drewsum/Analog_Clock/misc/custom_meter_name_plate_inverted.pdf

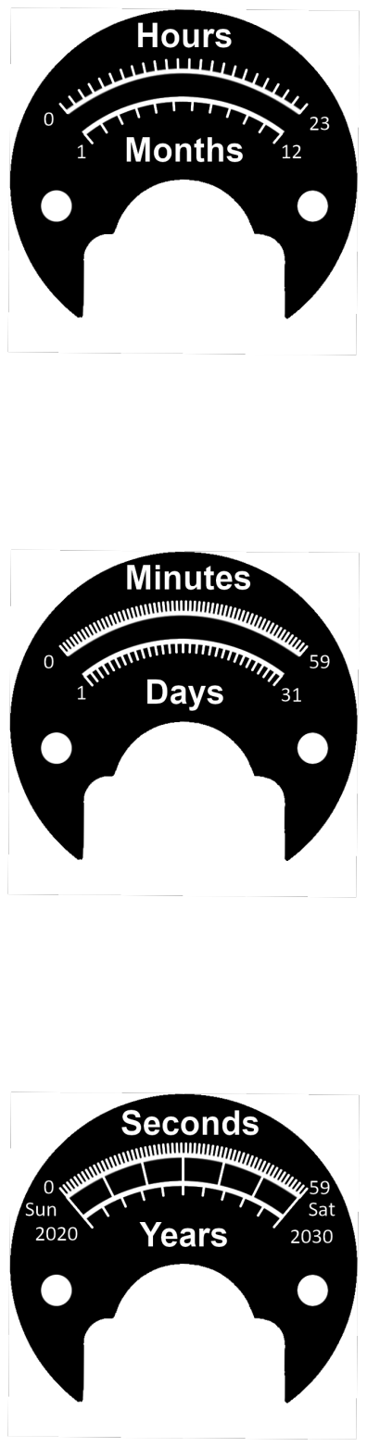
[picture p1: page 1]
