drewsum/Analog_Clock/misc/custom_meter_name_plate.pdf

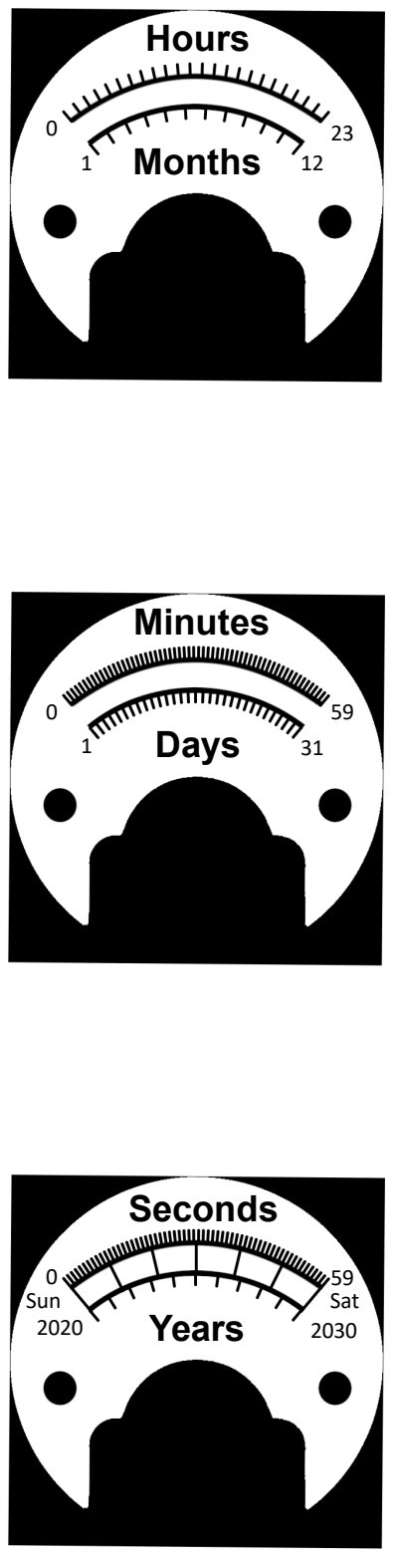
[picture p2: page 1]

Hours

Minutes

Seconds

1

1

2020

Sun | Sat

0

0

0

12

31

2030

23

59

59

Months

Days

Years
