drewsum/Analog_Clock/misc/image2020-11-04-160824-1.jpg

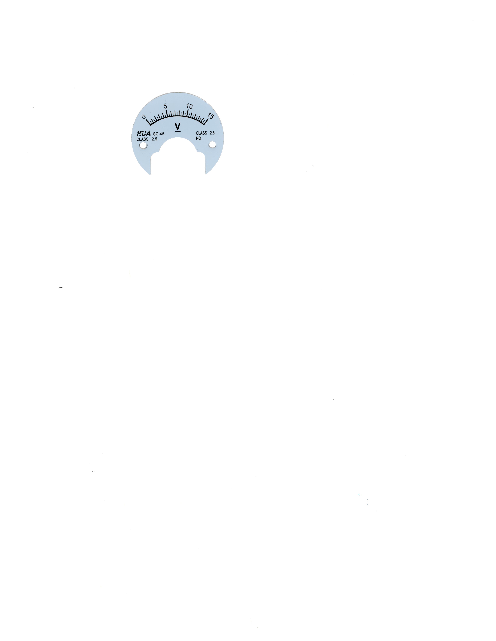
misc/image2020-11-04-160824-1.jpg
