drewsum/Analog_Clock/(threads)

Thread 1 (2020-02-05):

Ideas for this

drewsum, 2020-02-05:
* Use a voltage panel meter, preferably 0-5V but could also use 0-15V or something like that to add a higher voltage output and associated circuitry
* Would prefer to use a really retro set of round glass analog meters, as opposed to rectangular plastic ones
* Add warm LED backlight to the meters, make a set of custom cutouts to show hours, minutes, seconds
* Use a SPI DAC to control each meter. Use something like the DAC8551 for each meter
* Have a cool acrylic or metal laser cut front panel to hold everything together
* Can't decide if I want to solder the meters directly to the control board or have some wires as an interface
* Back could either be open or enclosed within wood or something
* 12V in, USB port (vertical mount instead of right angle), maybe bluetooth if you can figure it out
* ADC measurements for each analog output
* Consider using the 64 pin version of the PIC32MZ, probably don't need high memory option
* Maybe make panel meter backlight a configurable color?? Like RGB LEDs? That could be cool

drewsum, 2020-02-05:
* Consider having two boards, one that has all logic and power and the other that breaks out the connections to the meters. This would simplify layout of the control board but would make this more expensive/drive size thicker

drewsum, 2020-02-05:
* Consider mechanical pushbuttons as a way to set the time

drewsum, 2020-02-13:
Use the OPA990 as the analog output gain stage/buffer

drewsum, 2020-02-14:
> ~Use the OPA990 as the analog output gain stage/buffer~ This is a new part and doesn't appear to be available

Dropping this in favor of the OPA2197 in VSSOP-8, going to use amp A as gain stage and amp B as  a low pass filter for driving the meters. This is a nice option since KiCad already has this

drewsum, 2020-02-14:
You can get away with using a taller axial battery in this application. Don't do two boards, this only needs one

Closed 2020-10-15.

Thread 4 (2020-04-20):

Change VCCIO on FT234 to 3.3V

drewsum, 2020-04-20:
Abs Max: VCCIO IO Voltage -0.3 to +4.0

You've violated this on every board you've ever made with this, hahaha

Closed 2020-10-15.

Thread 5 (2020-08-13):

Consider tying a PWM output pin to heartbeat LED

drewsum, 2020-08-13:
You could change heartbeat timer from 1s period to 1ms, and update a PWM output to fade the heartbeat LED on and off. This would also provide a millisecond timer. Could be useful for heartbeat timer to be 1ms period rather than 1s period

Closed 2020-10-15.

Thread 10 (2020-11-01):

I2C devices don't initialize properly on a power on reset without USB plugged in

drewsum, 2020-11-01:

drewsum, 2020-11-01:
You can see evidence of this since calling `Platform Status?` shows that the LP5009 is not enabled after POR, even after init code executes

Closed 2020-11-13.

Thread 13 (2020-12-01):

Firmware Bug Fixes

drewsum, 2020-12-01:
* Middle meter voltage range is messed up after adding new meter inserts
* INA219 Print Status function prints the opposite BUS voltage range setting (16V instead of 32V, 32V instead of 16V)

Closed 2020-12-06.
