drewsum/Analog_Clock/hdw/Analog_Clock/Analog_Clock.pdf

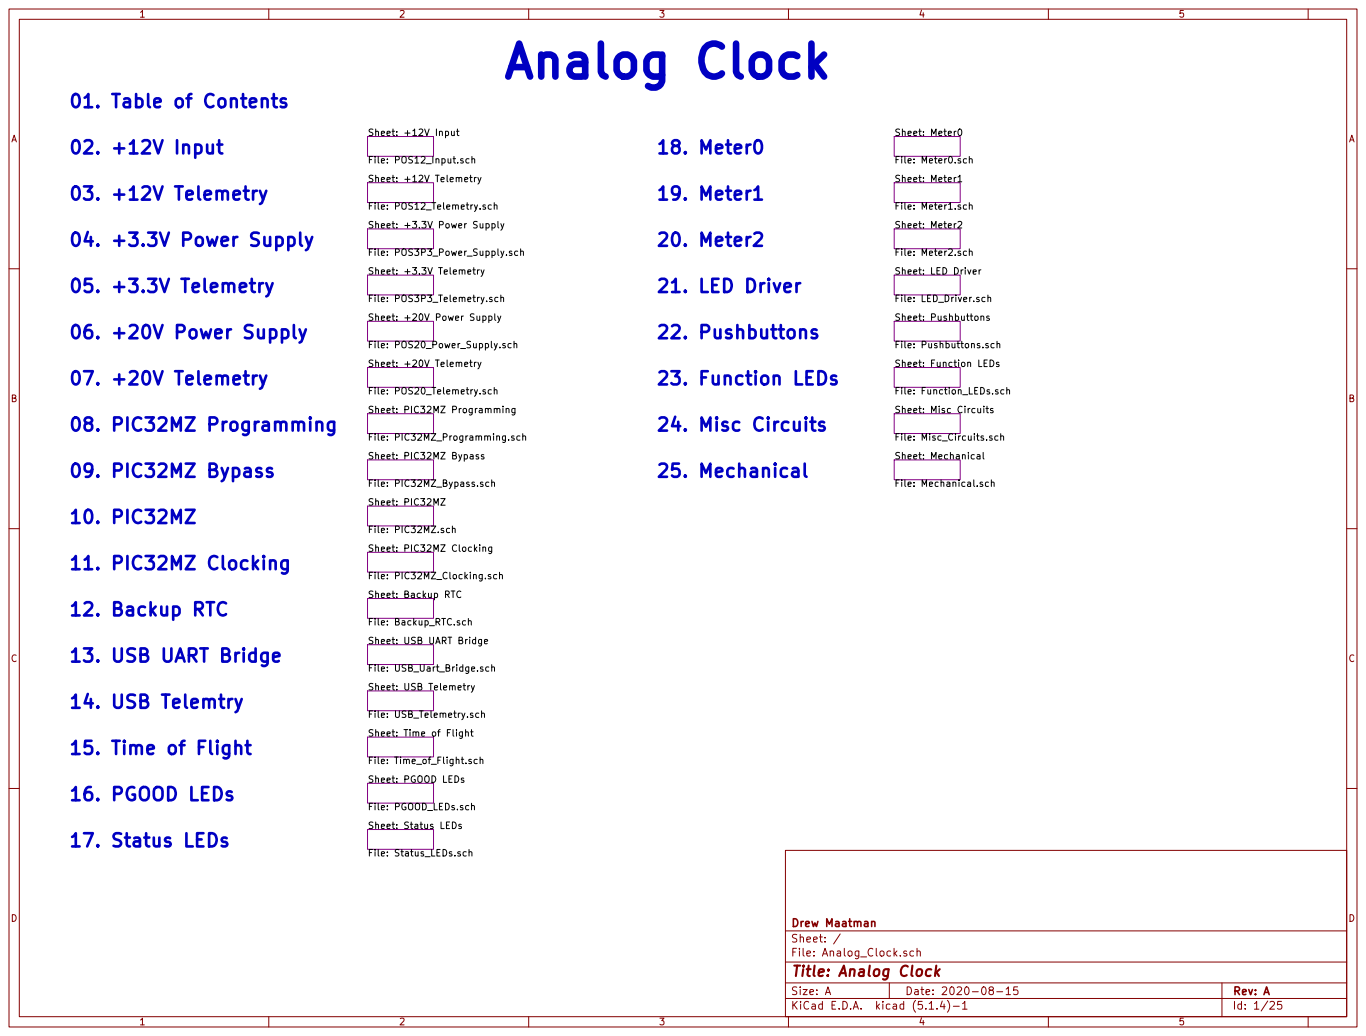
[picture p4: page 1]

File: POS12_Telemetry.sch Sheet: Status LEDs File: Status_LEDs.sch Sheet: PGOOD LEDs File: PGOOD_LEDs.sch Sheet: Time of Flight
Sheet: +3.3V Power Supply

File: PIC32MZ_Programming.sch
File: PIC32MZ.sch Sheet: PIC32MZ Bypass

File: Analog_Clock.sch Sheet: / Drew Maatman

Id: 1/25 Title: Analog Clock

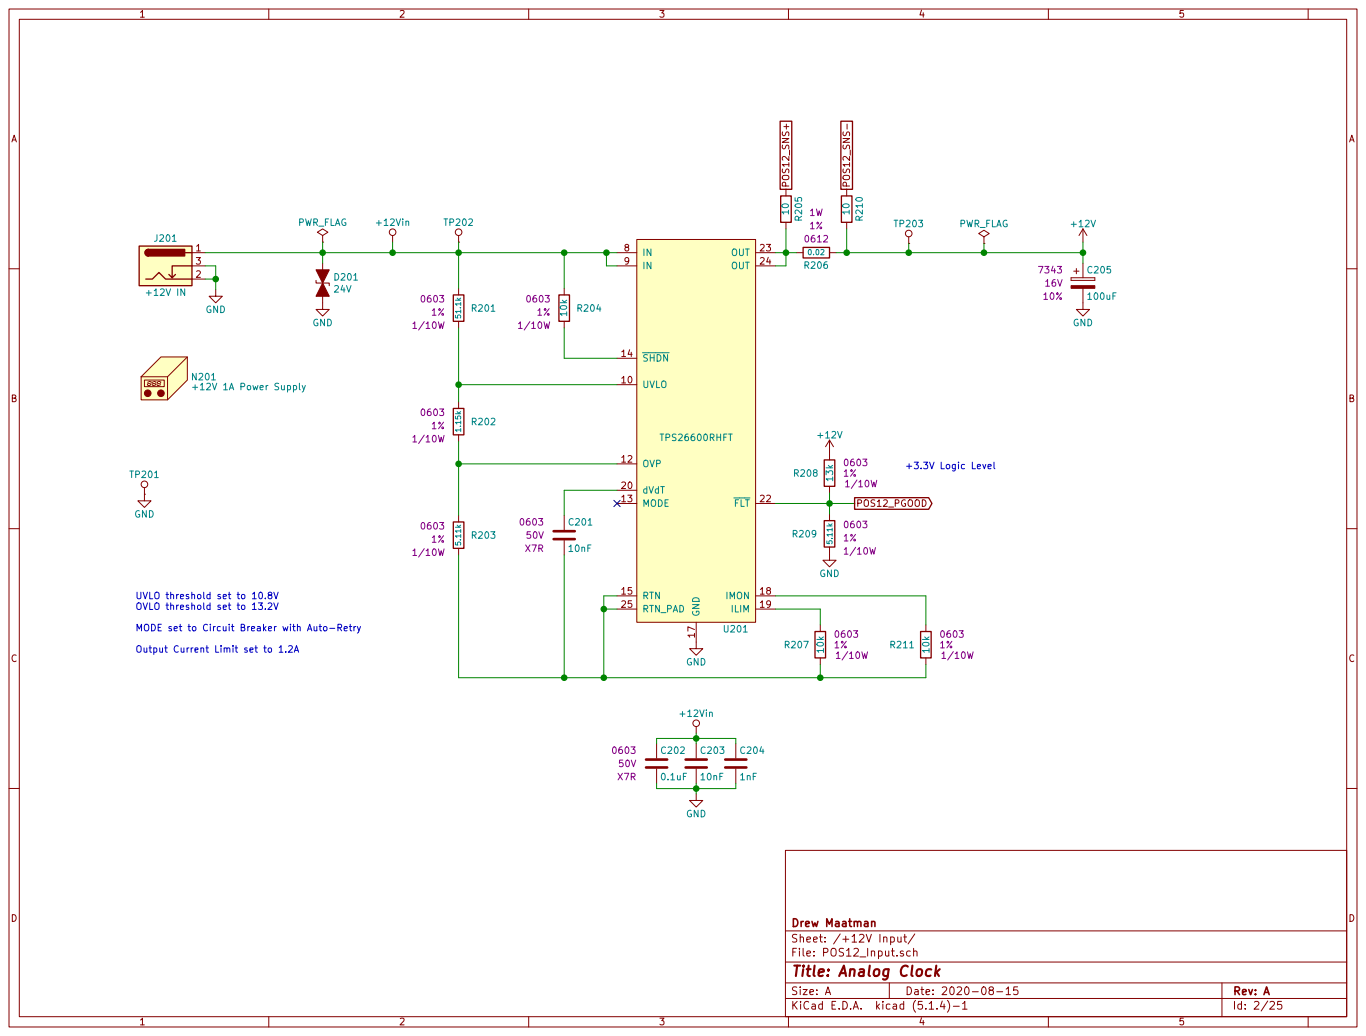
[picture p5: page 2]

+3.3V Logic Level UVLO threshold set to 10.8V OVLO threshold set to 13.2V MODE set to Circuit Breaker with Auto-Retry

Output Current Limit set to 1.2A

File: POS12_Input.sch
Id: 2/25 Title: Analog Clock

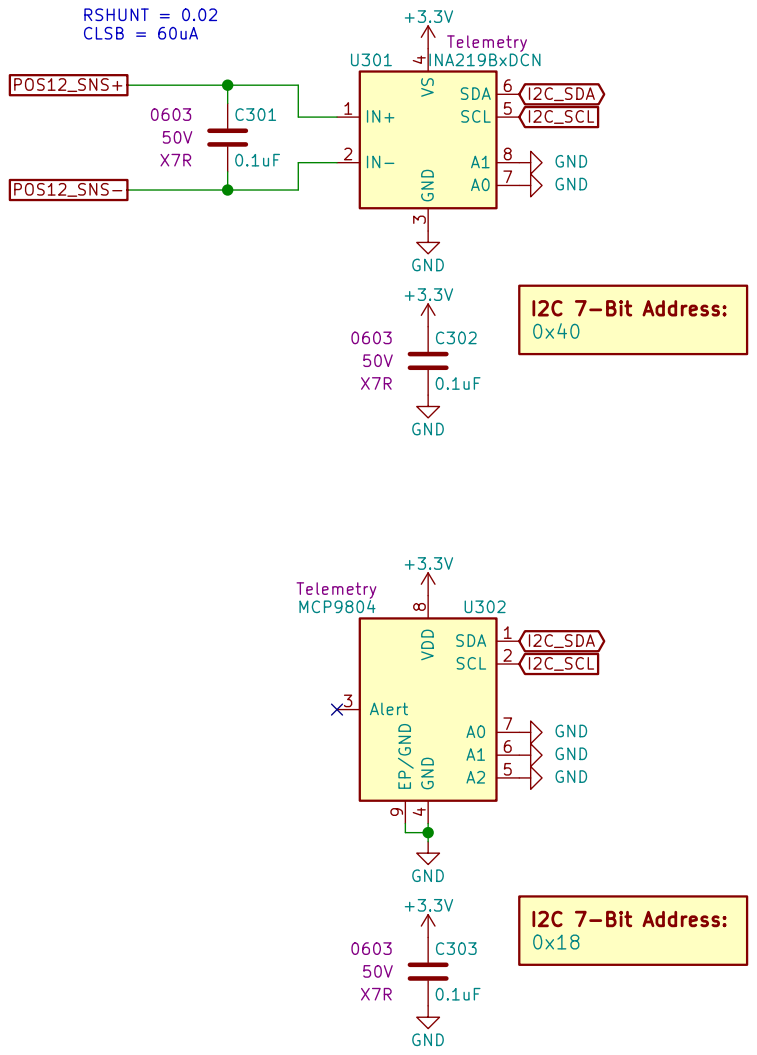
[picture p6: page 3]

Sheet: /+12V Telemetry/ Drew Maatman

File: POS12_Telemetry.sch
Id: 3/25 Title: Analog Clock

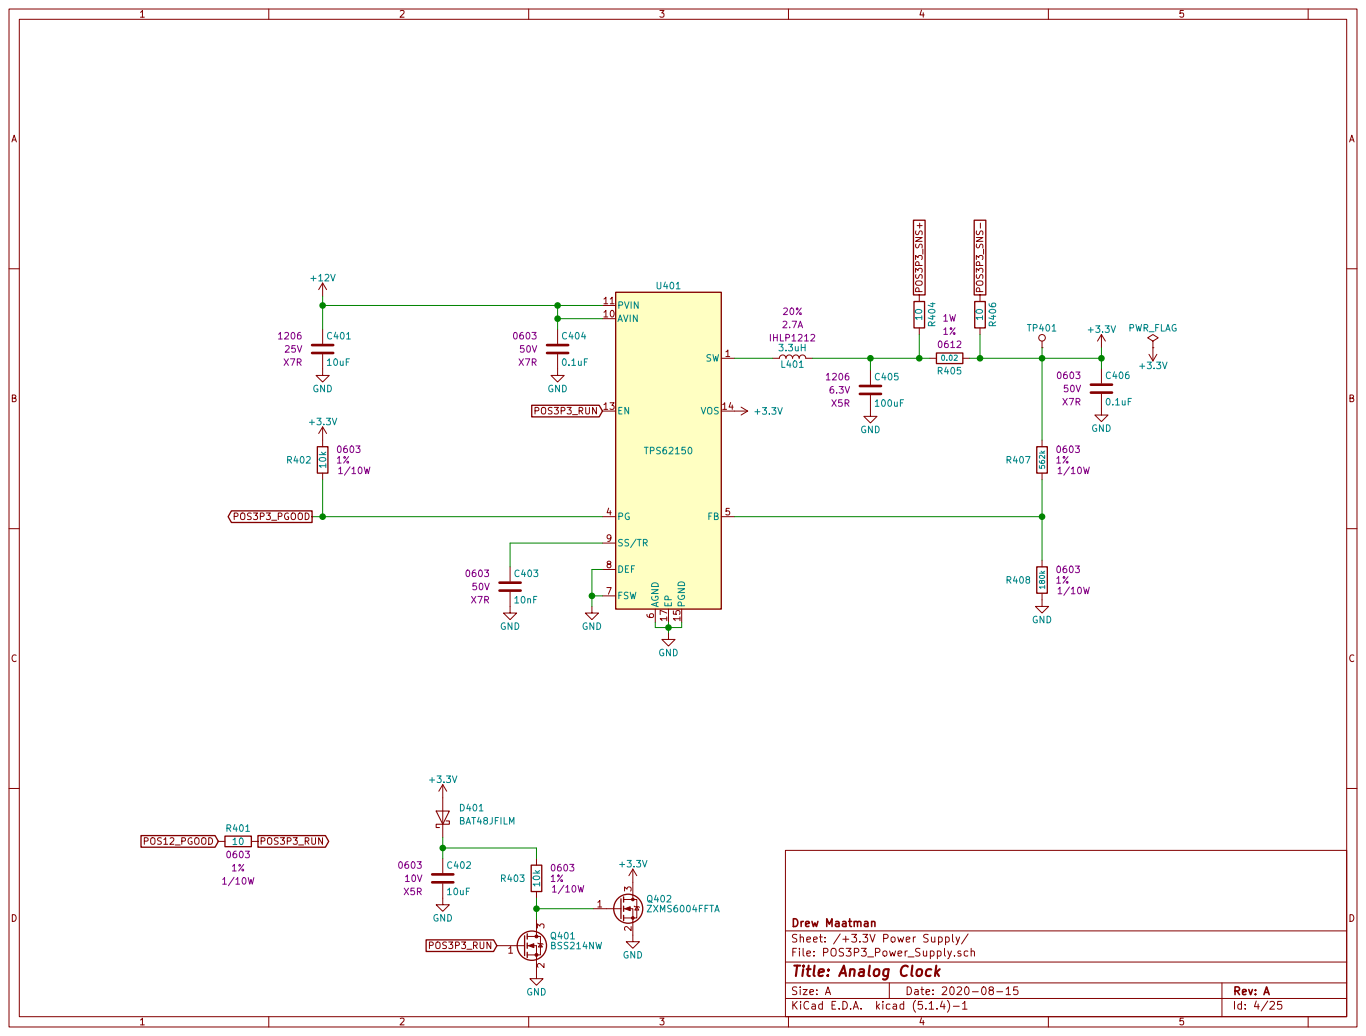
[picture p7: page 4]

6 FSW 7 DEF 8 SS/TR 9 U401 TPS62150 POS3P3_RUN

File: POS3P3_Power_Supply.sch
Id: 4/25 Title: Analog Clock

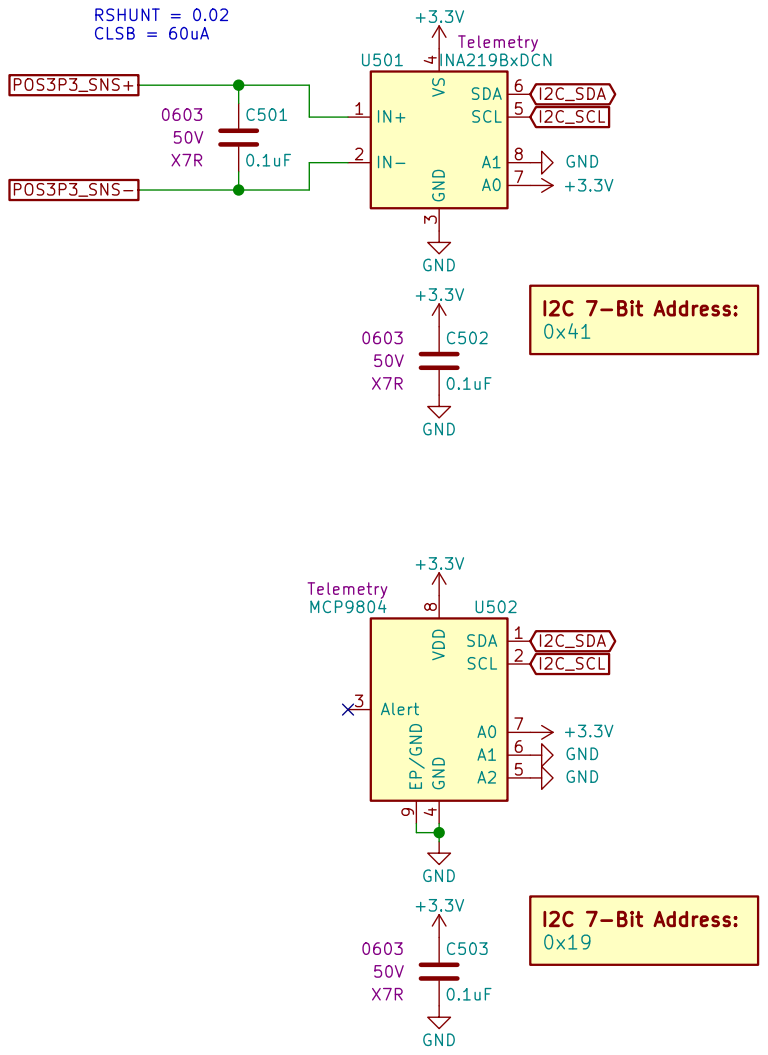
[picture p8: page 5]

Sheet: /+3.3V Telemetry/ Drew Maatman

File: POS3P3_Telemetry.sch
Id: 5/25 Title: Analog Clock

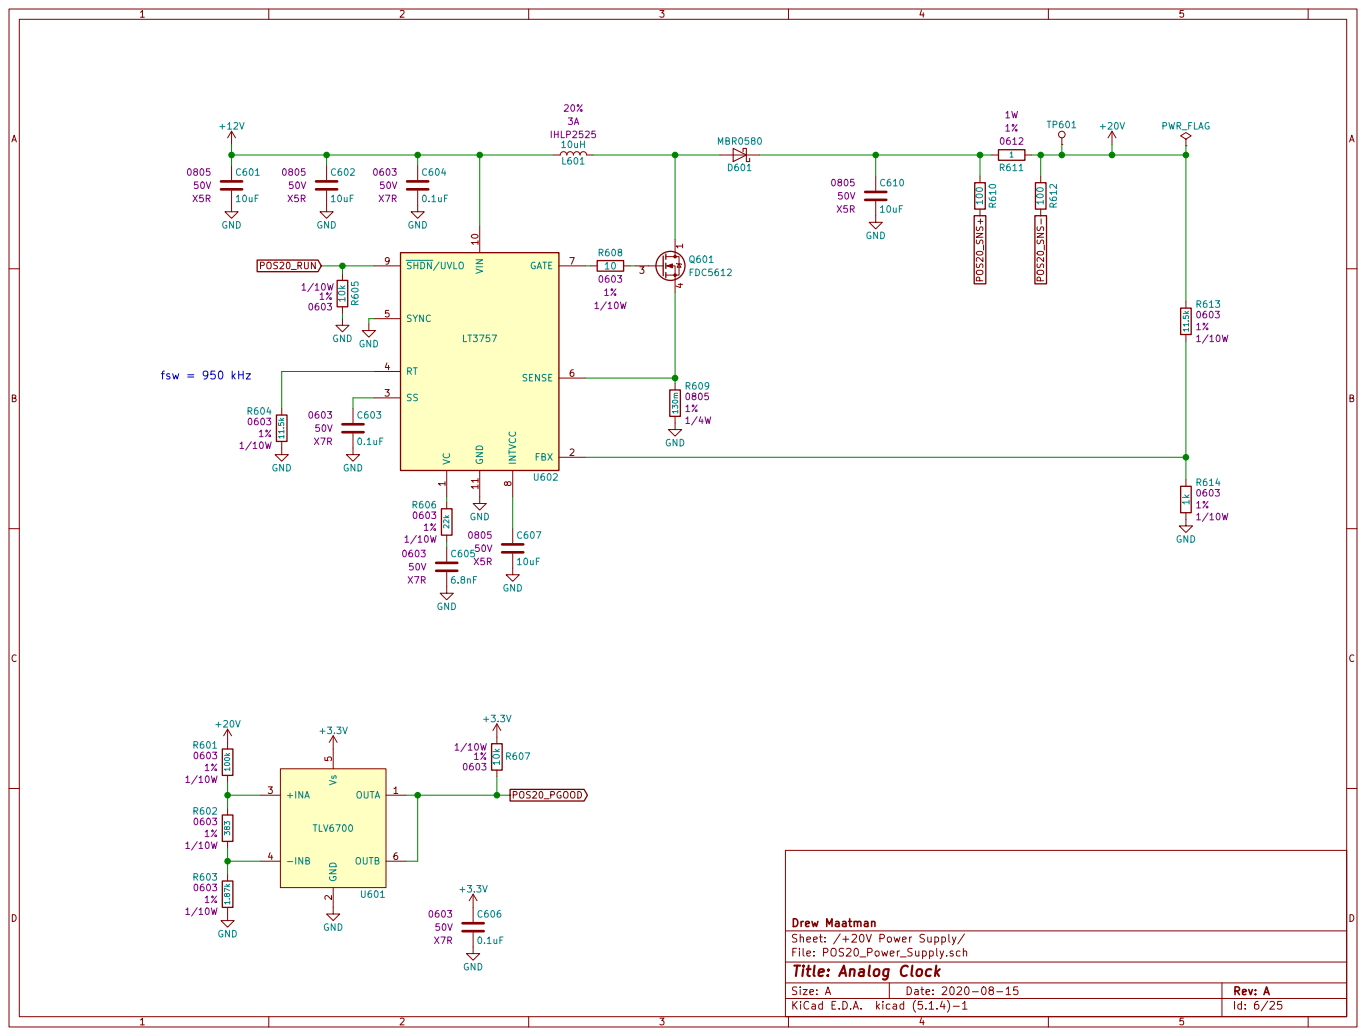
[picture p9: page 6]

1 VIN 10 GND 11 FBX 2 SS 3 RT 4 SYNC 5 SENSE 6 GATE 7 INTVCC

Sheet: /+20V Power Supply/ Drew Maatman GND R605 10k 0603

File: POS20_Power_Supply.sch
Id: 6/25 Title: Analog Clock

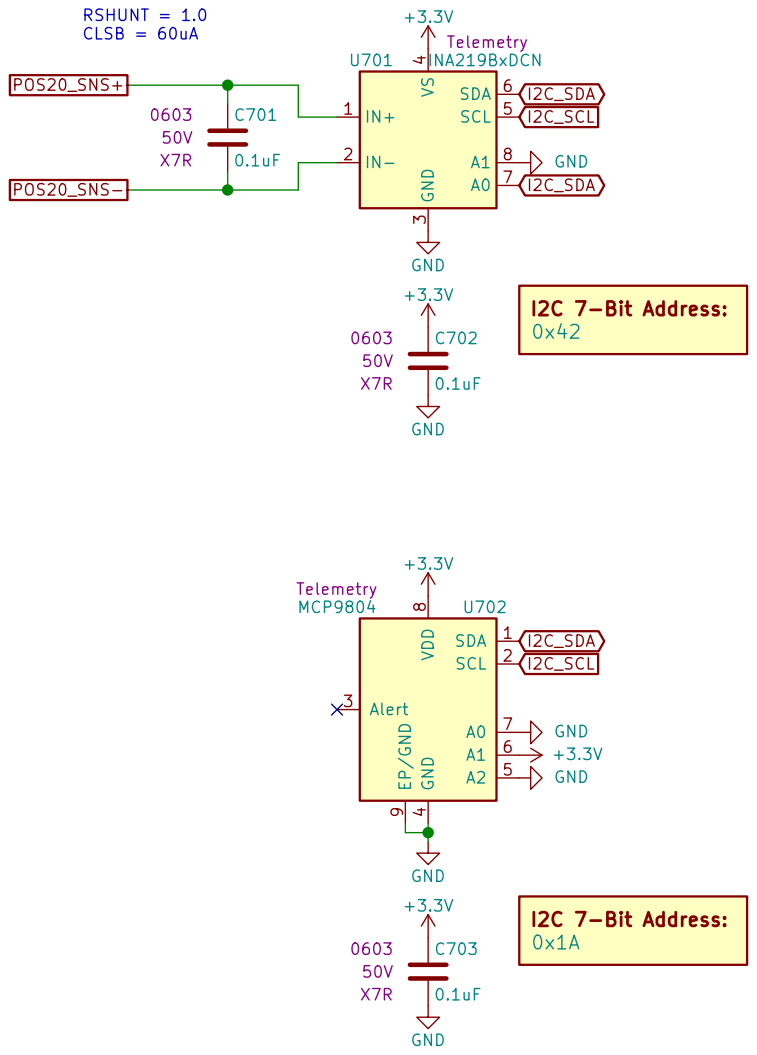
[picture p10: page 7]

Sheet: /+20V Telemetry/ Drew Maatman

File: POS20_Telemetry.sch
Id: 7/25 Title: Analog Clock

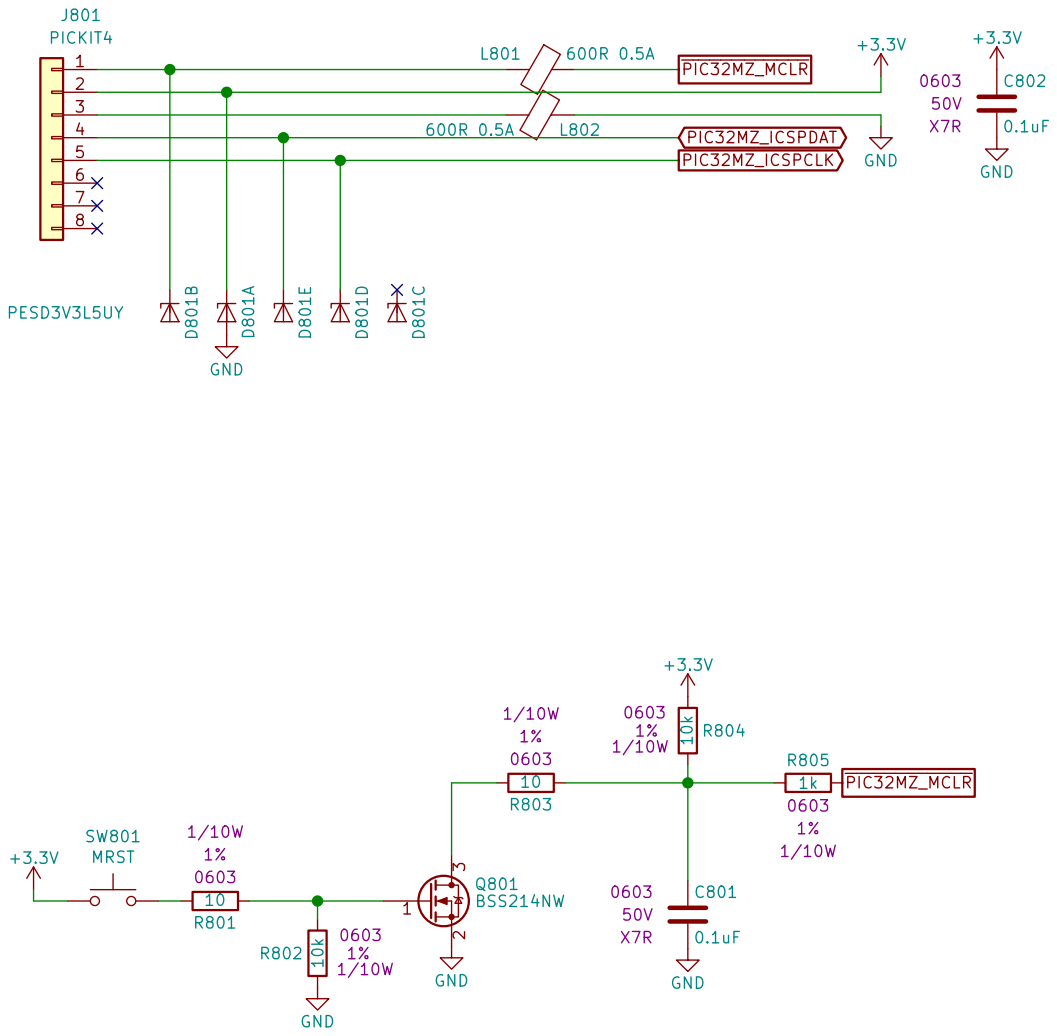
[picture p11: page 8]

File: PIC32MZ_Programming.sch
Id: 8/25 Title: Analog Clock

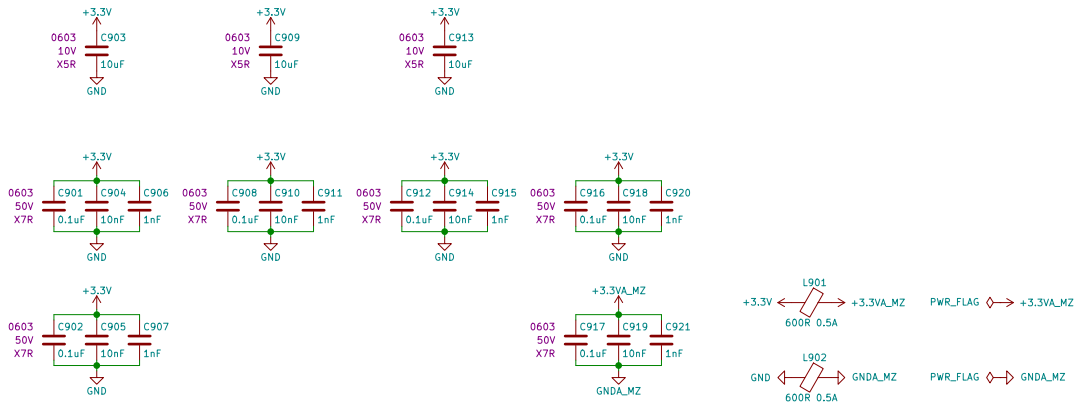
[picture p12: page 9]

File: PIC32MZ_Bypass.sch
Id: 9/25 Title: Analog Clock

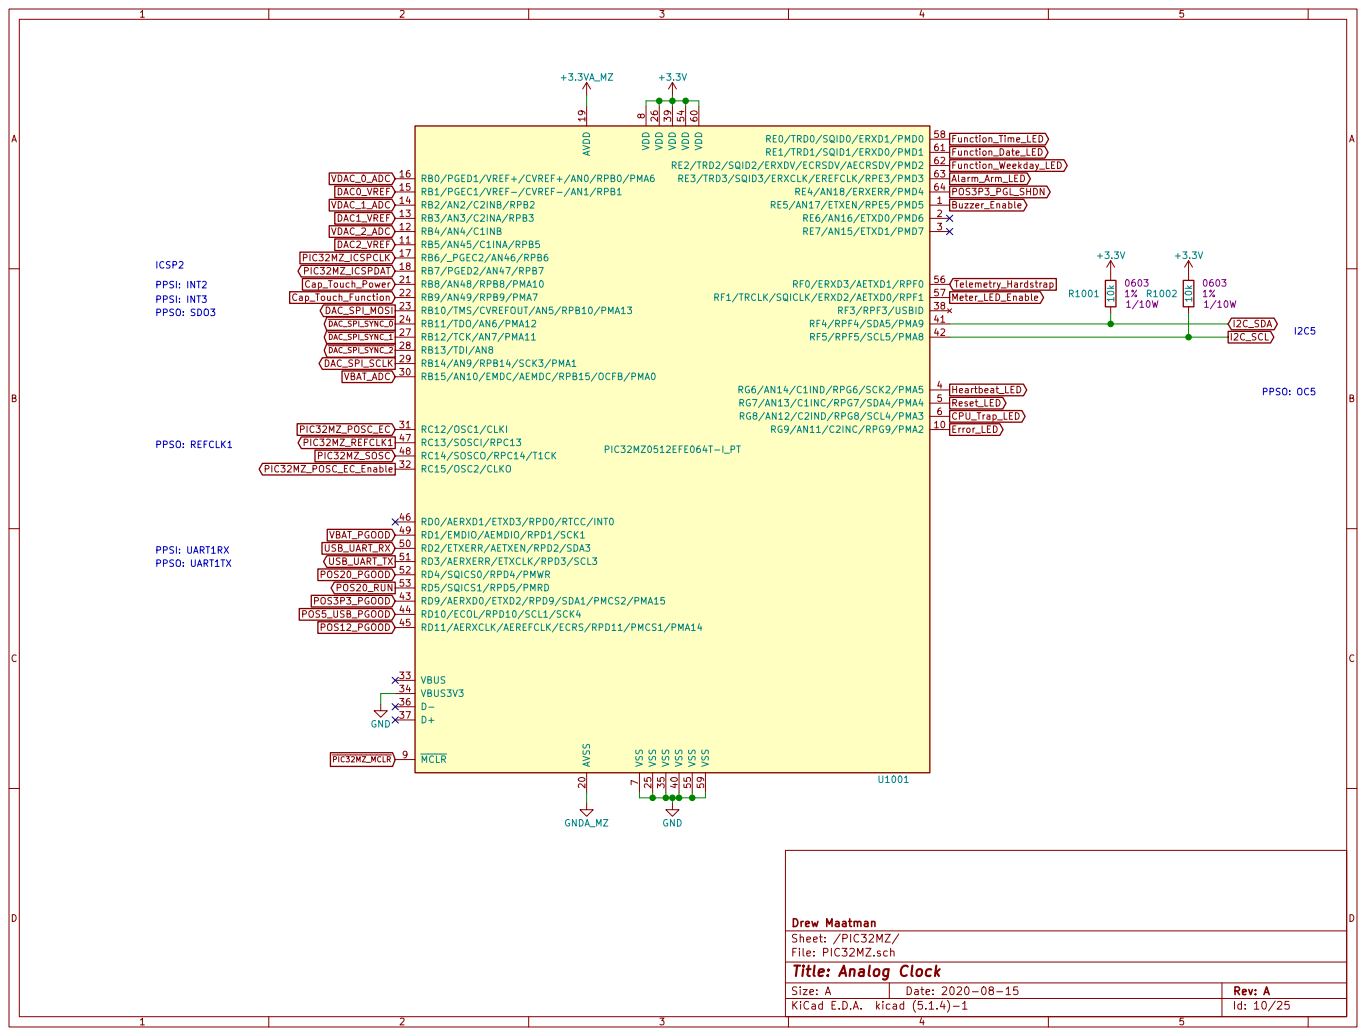
[picture p13: page 10]

File: PIC32MZ.sch Sheet: /PIC32MZ/ Drew Maatman

Id: 10/25 Title: Analog Clock

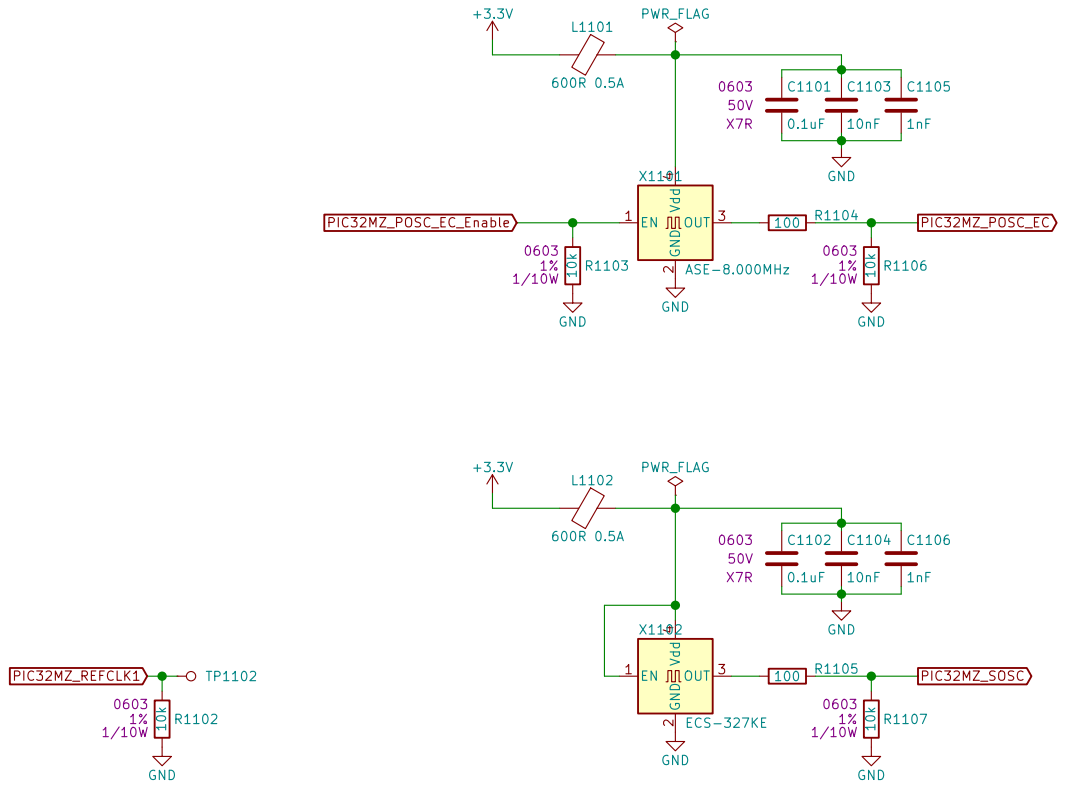
[picture p14: page 11]

Sheet: /PIC32MZ Clocking/ Drew Maatman

File: PIC32MZ_Clocking.sch
Id: 11/25 Title: Analog Clock

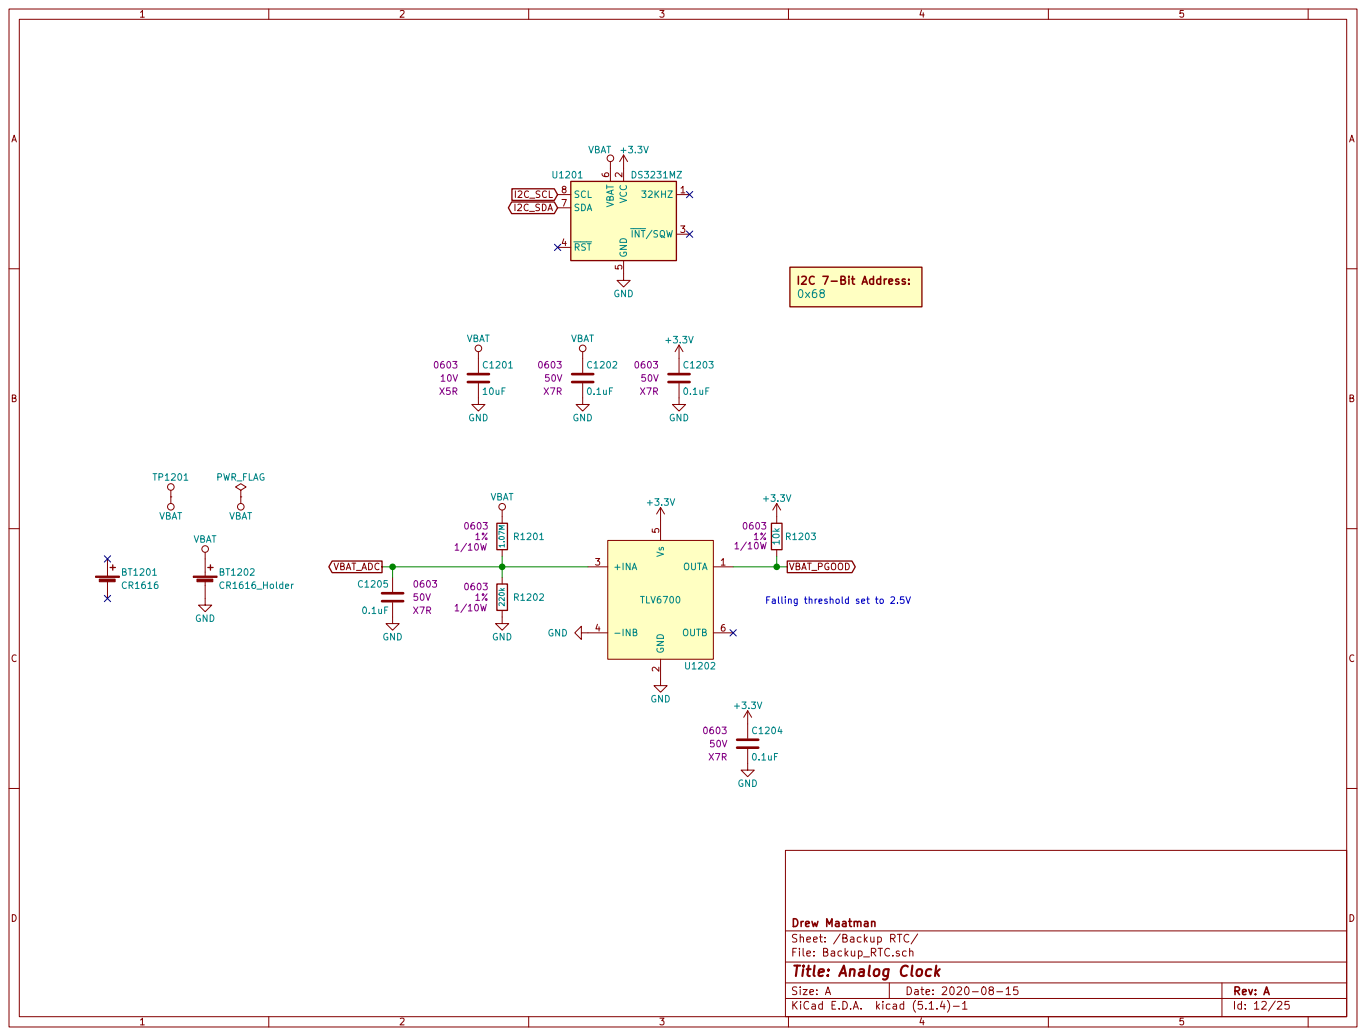
[picture p15: page 12]

File: Backup_RTC.sch
Id: 12/25 Title: Analog Clock

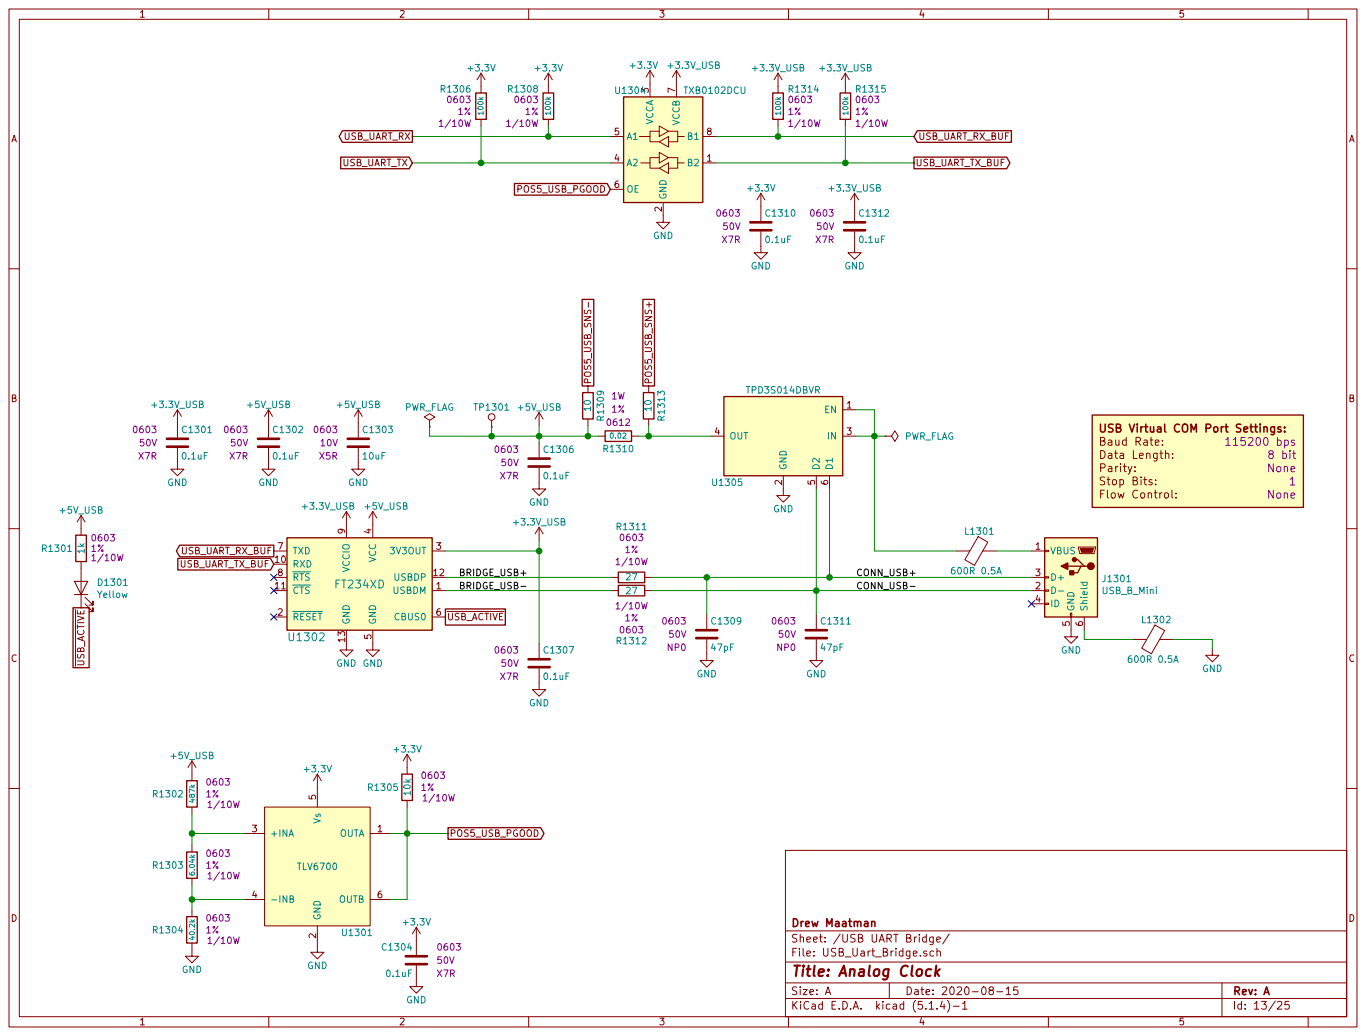
[picture p16: page 13]

9 U1302 FT234XD R1313 10 GND GND GND GND GND GND GND OUTA 1 GND

USB Virtual COM Port Settings:

Sheet: /USB UART Bridge/ Drew Maatman GND

File: USB_Uart_Bridge.sch
Id: 13/25 Title: Analog Clock

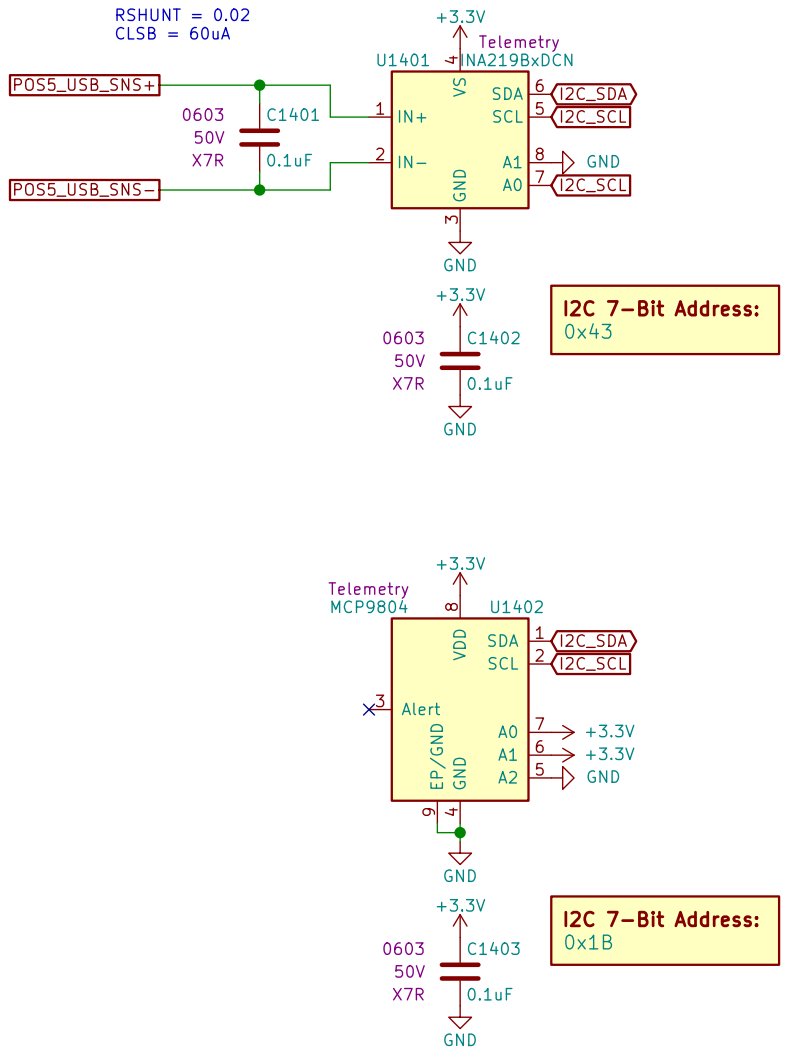
[picture p17: page 14]

Sheet: /USB Telemetry/ Drew Maatman

File: USB_Telemetry.sch
Id: 14/25 Title: Analog Clock

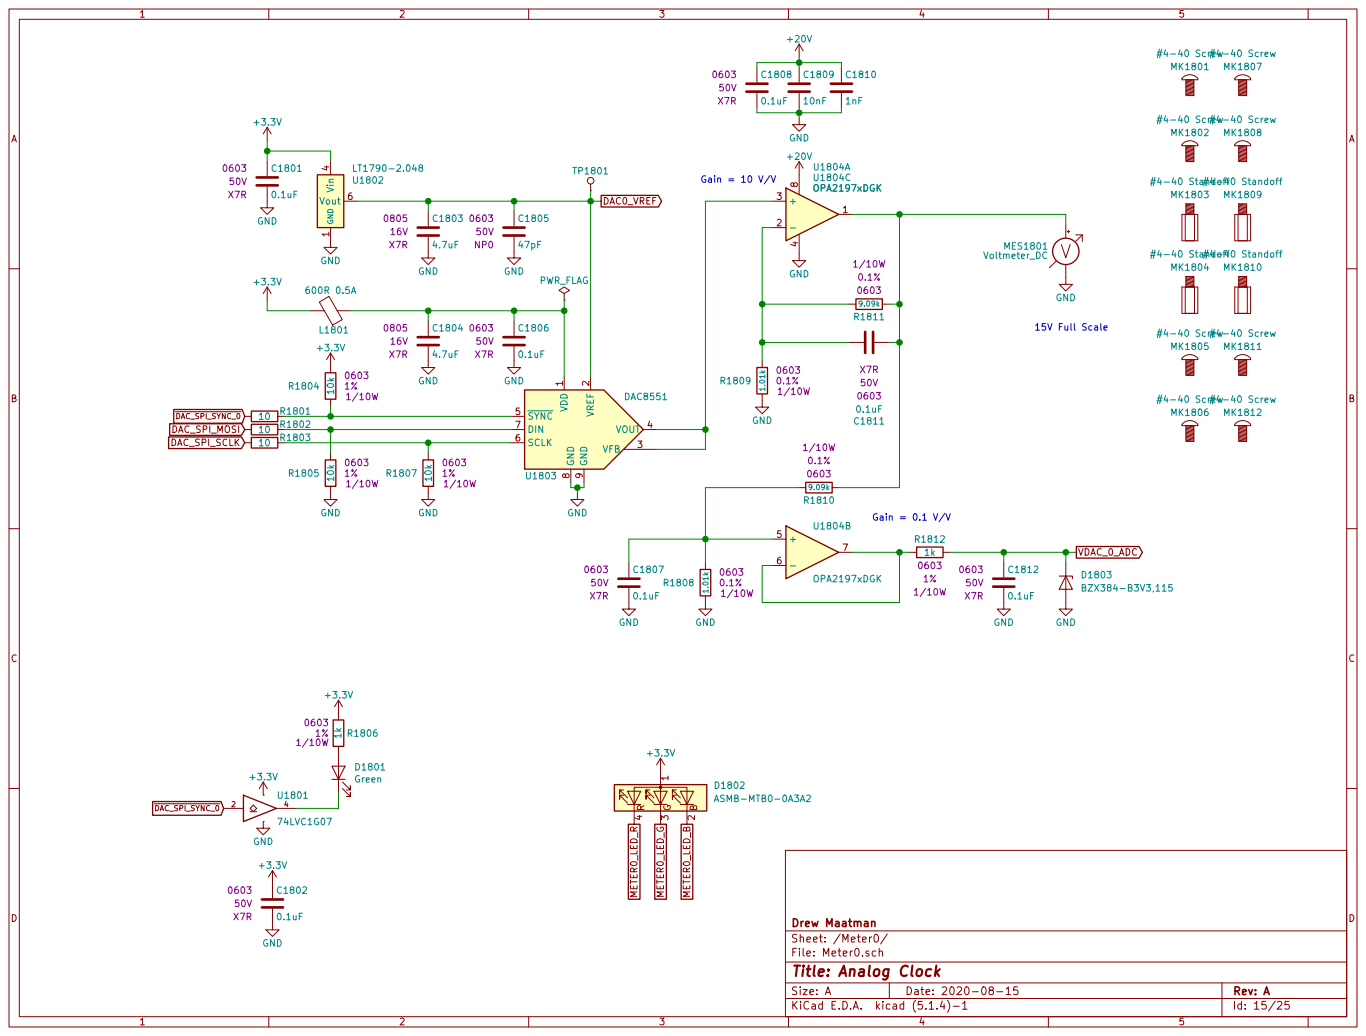
[picture p18: page 15]

15V Full Scale Gain = 0.1 V/V Gain = 10 V/V

2 VFB 3 VOUT 4 SYNC 5 SCLK 6 DIN 7 GND

Id: 15/25 Title: Analog Clock

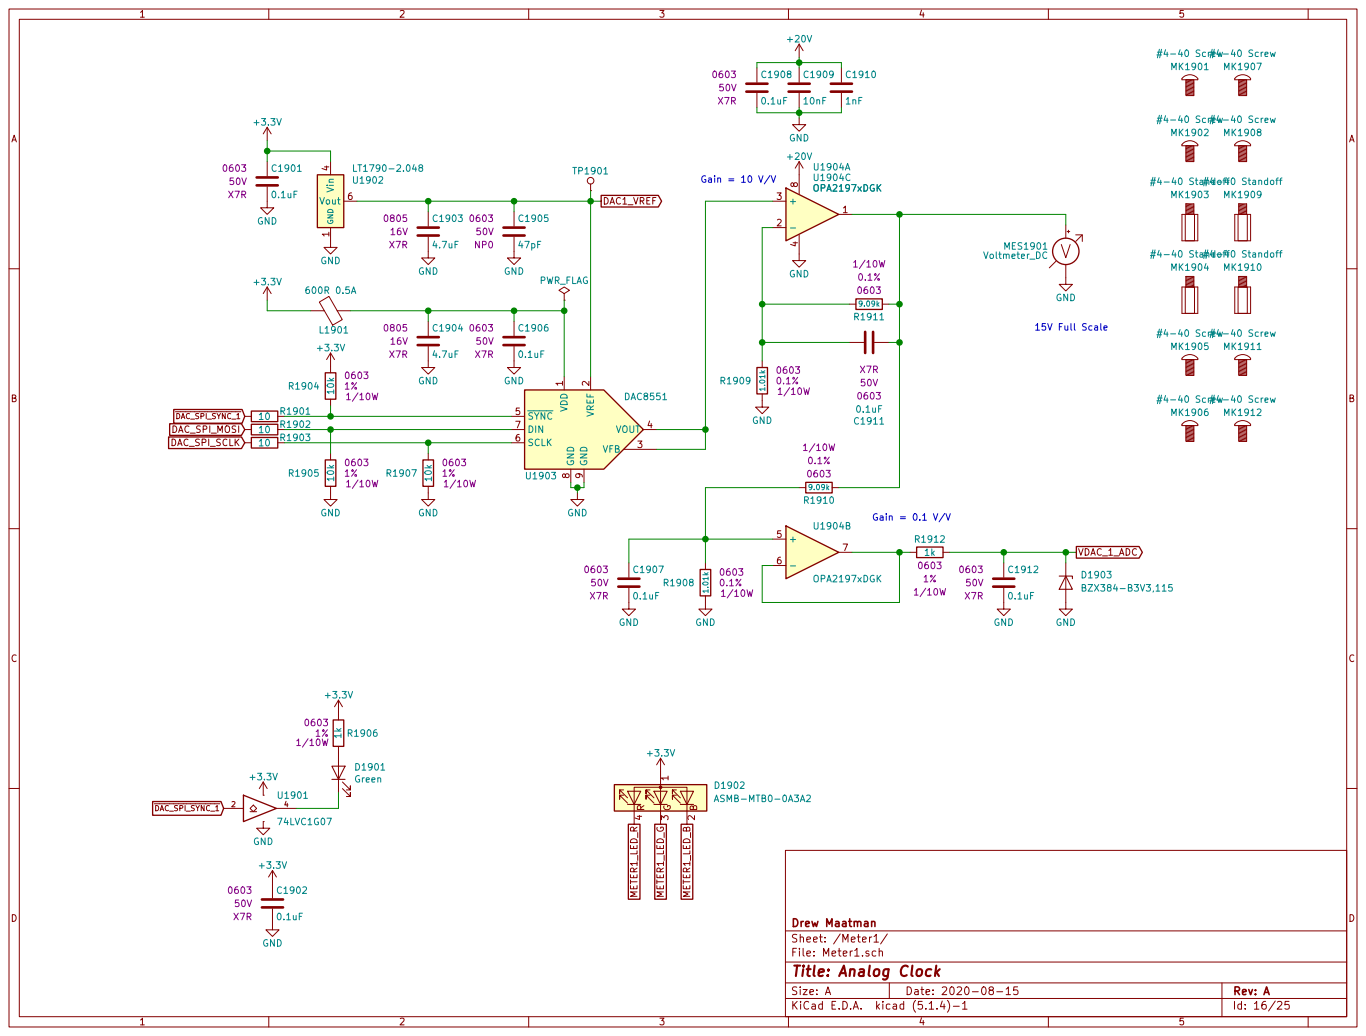
[picture p19: page 16]

File: Meter1.sch Sheet: /Meter1/ Drew Maatman V- 4 V+

15V Full Scale Gain = 0.1 V/V Gain = 10 V/V

2 VFB 3 VOUT 4 SYNC 5 SCLK 6 DIN 7 GND

Id: 16/25 Title: Analog Clock

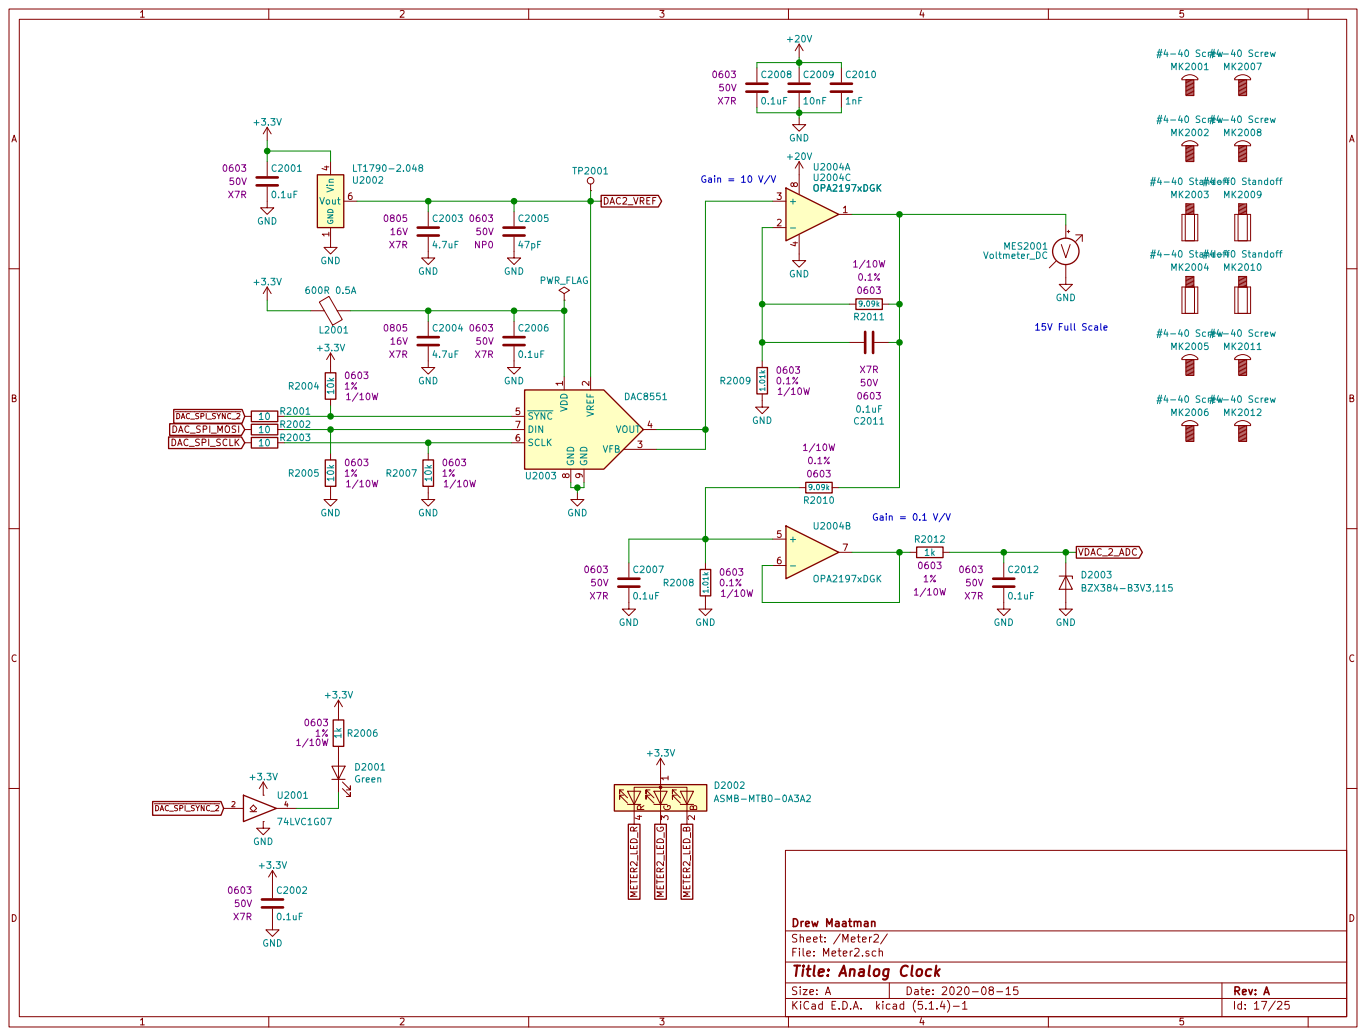
[picture p20: page 17]

File: Meter2.sch Sheet: /Meter2/ Drew Maatman V- 4 V+

15V Full Scale Gain = 0.1 V/V Gain = 10 V/V

2 VFB 3 VOUT 4 SYNC 5 SCLK 6 DIN 7 GND

Id: 17/25 Title: Analog Clock

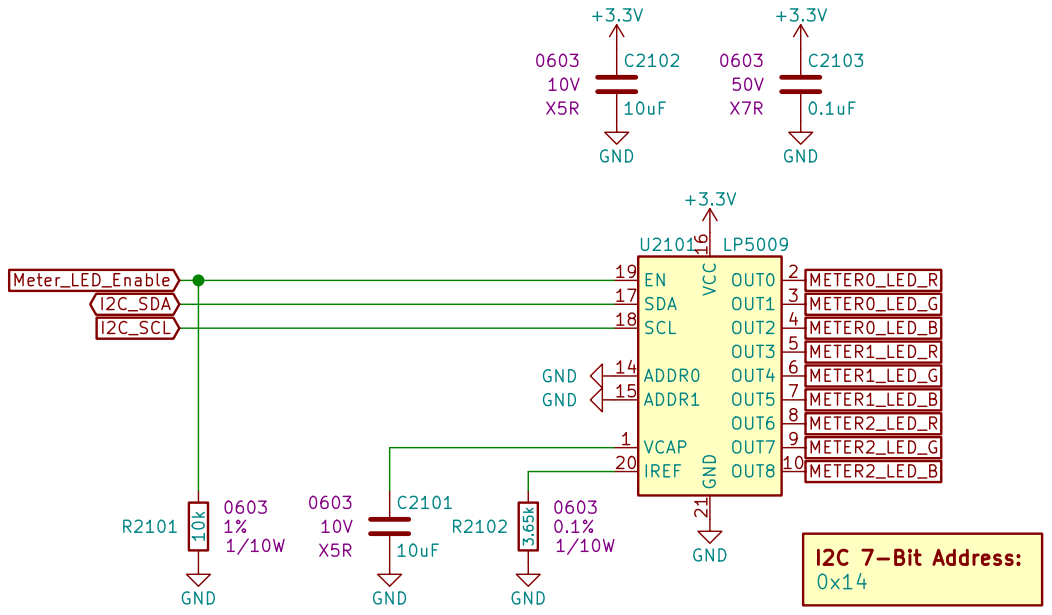
[picture p21: page 18]

File: LED_Driver.sch Sheet: /LED Driver/ Drew Maatman

Id: 18/25 Title: Analog Clock

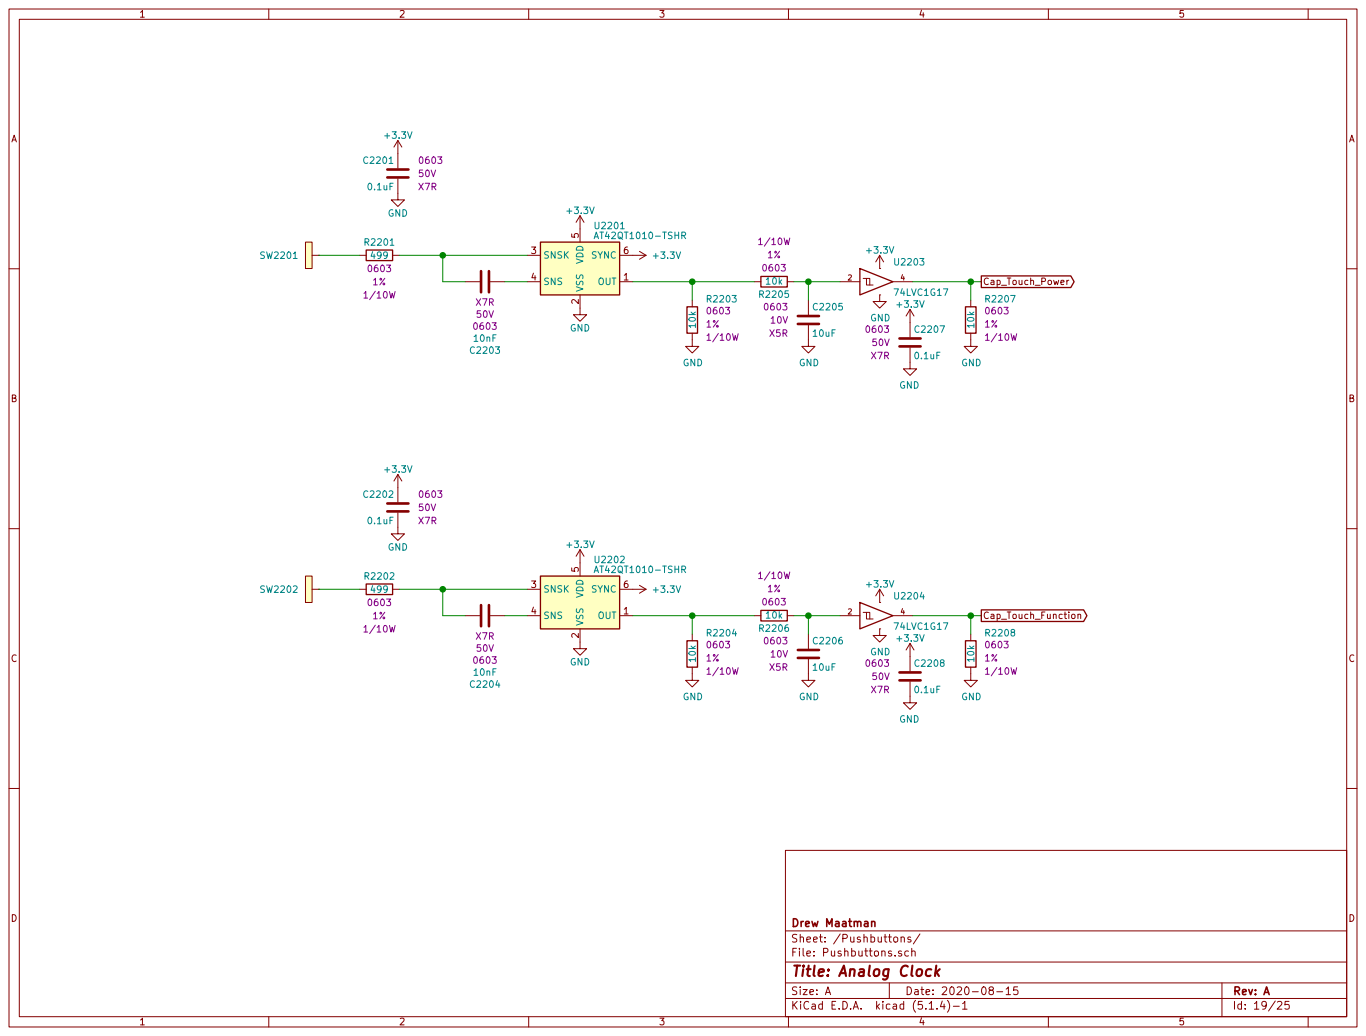
[picture p22: page 19]

Id: 19/25 Title: Analog Clock

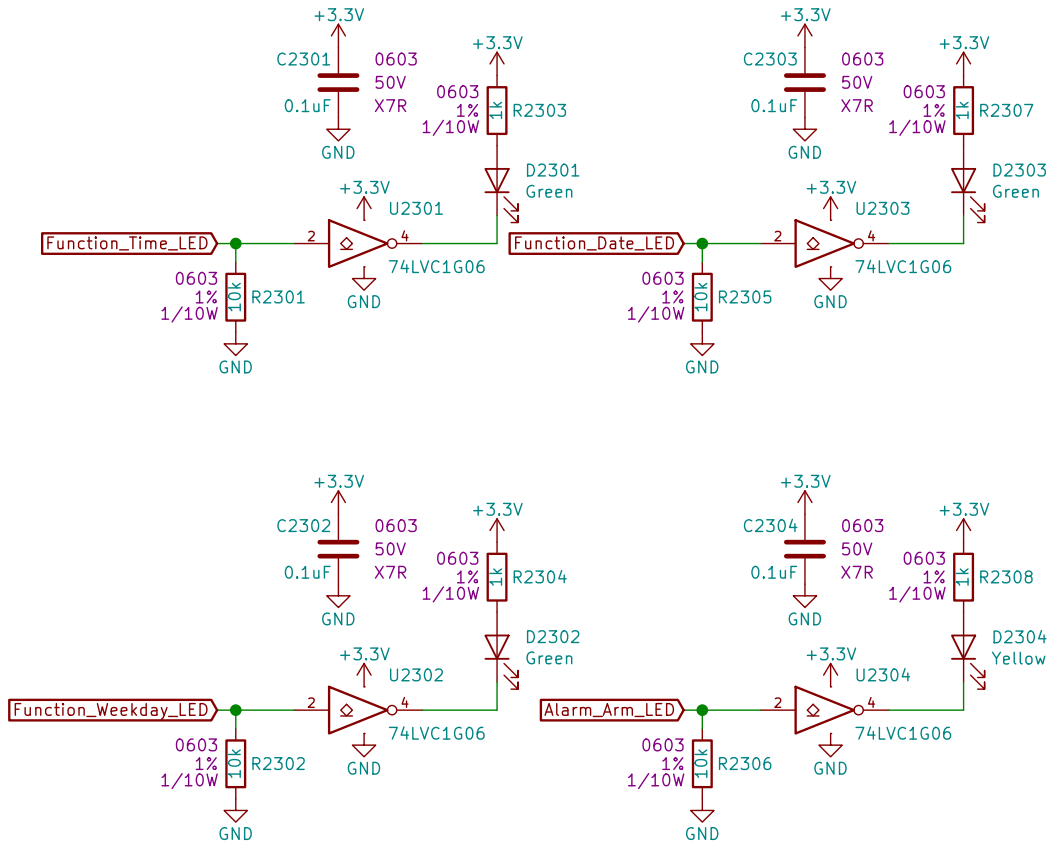
[picture p23: page 20]

File: Function_LEDs.sch Sheet: /Function LEDs/ Drew Maatman GND GND

Id: 20/25 Title: Analog Clock

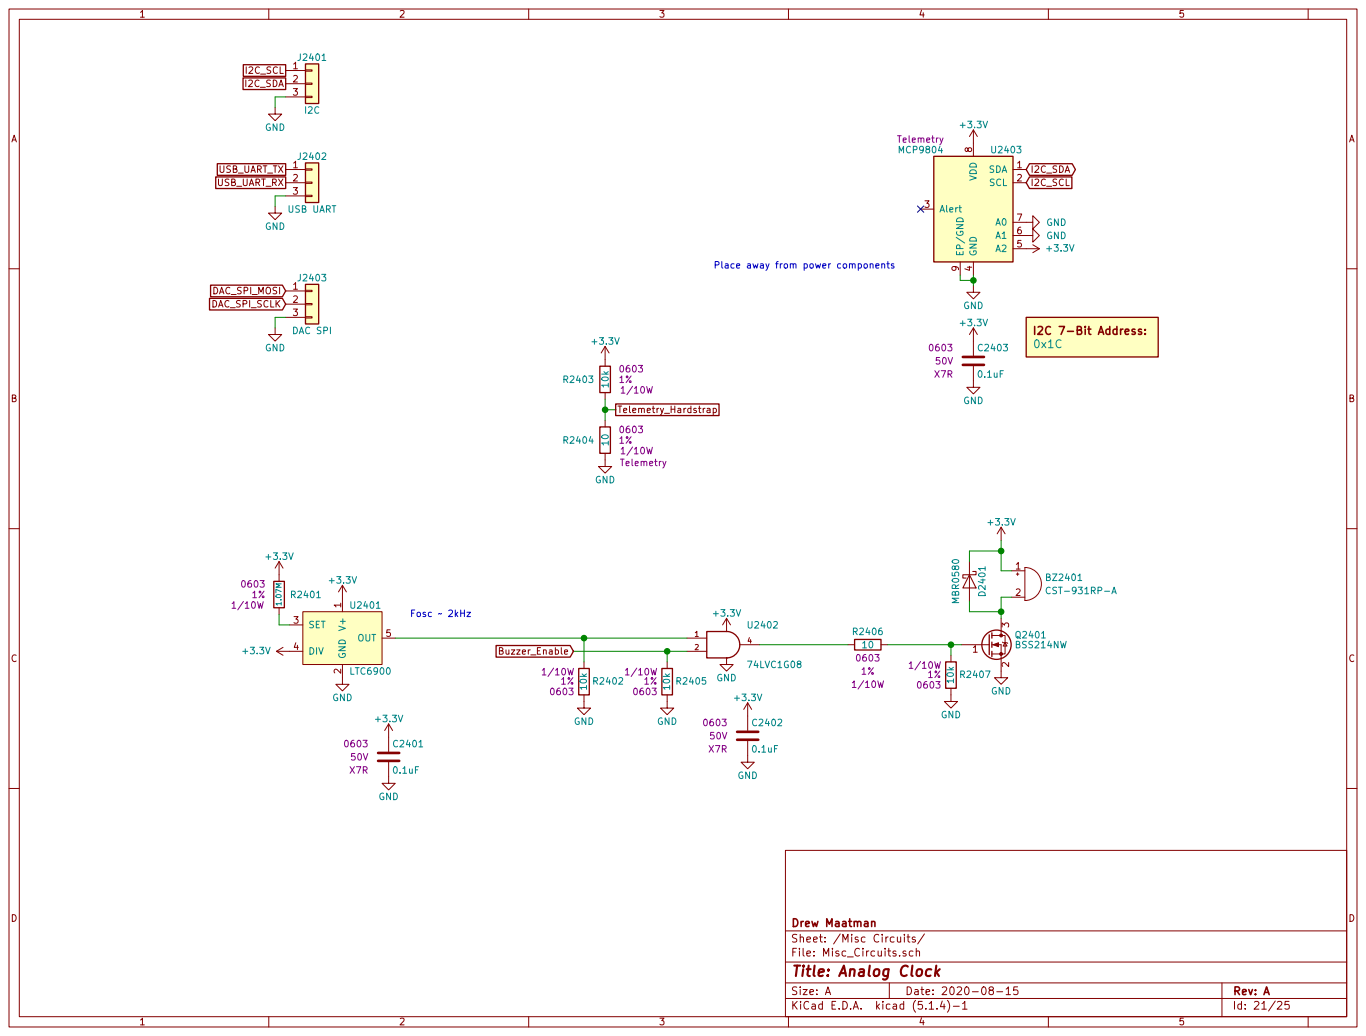
[picture p24: page 21]

File: Misc_Circuits.sch Sheet: /Misc Circuits/ Drew Maatman C2402

Id: 21/25 Title: Analog Clock

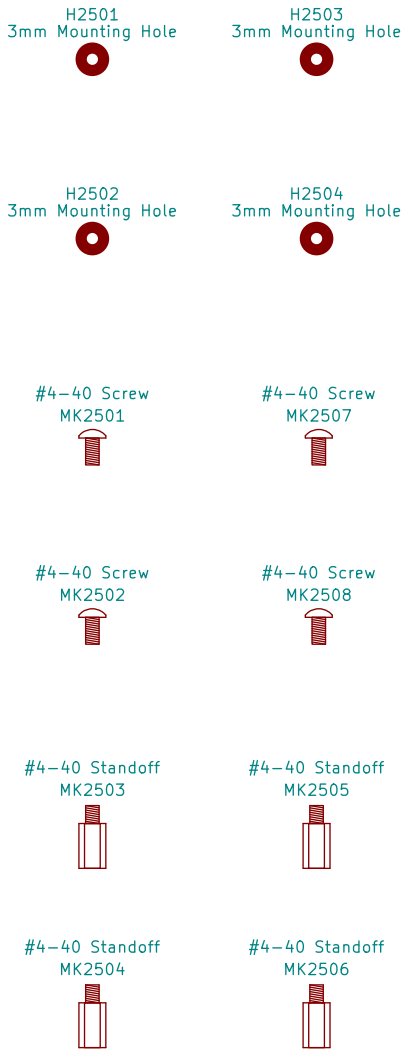
[picture p25: page 22]

File: Mechanical.sch Sheet: /Mechanical/ Drew Maatman

Id: 22/25 Title: Analog Clock

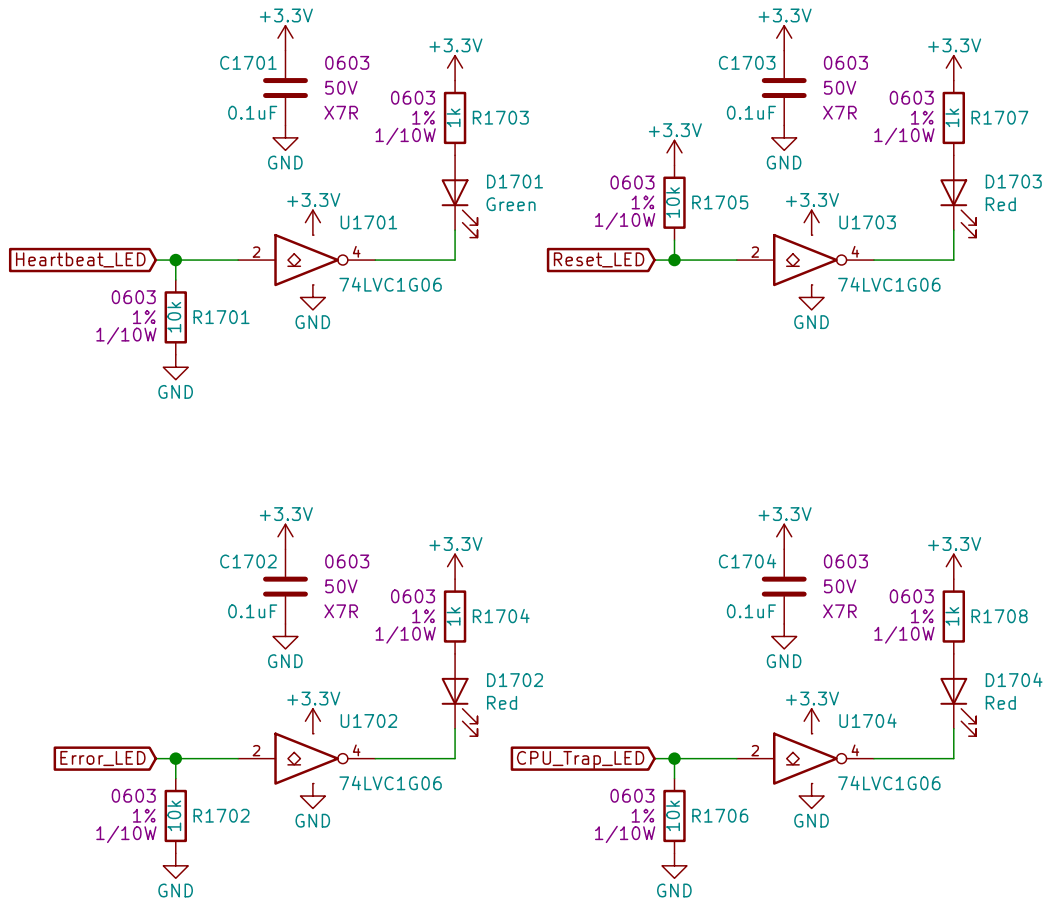
[picture p26: page 23]

File: Status_LEDs.sch Sheet: /Status LEDs/ Drew Maatman GND

Id: 23/25 Title: Analog Clock

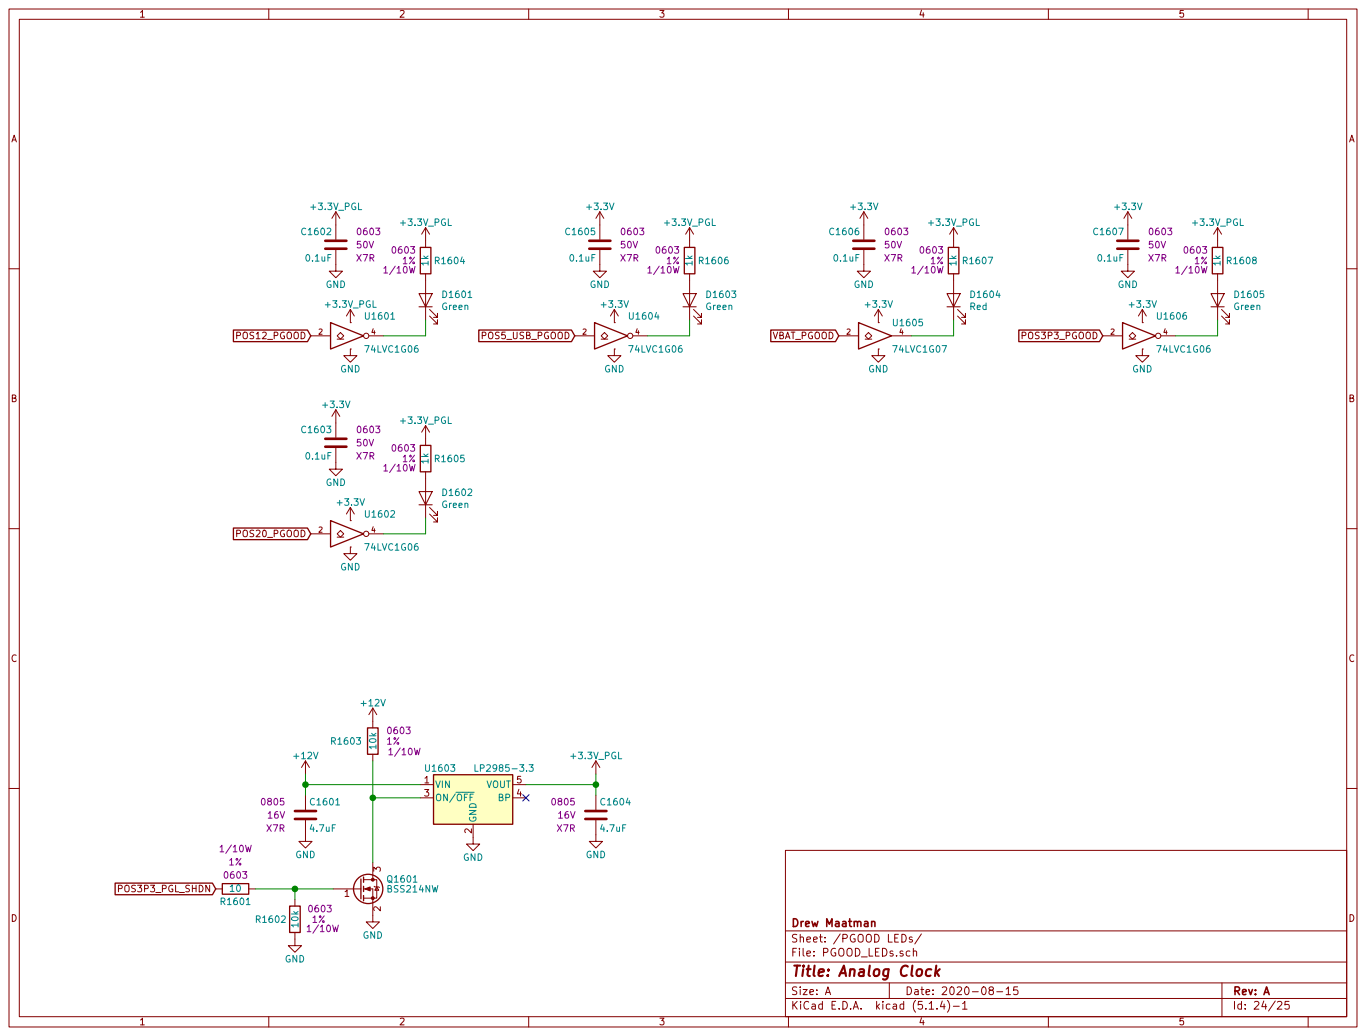
[picture p27: page 24]

2 ON/OFF 3 BP 4 VOUT 5 U1603 LP2985-3.3

File: PGOOD_LEDs.sch Sheet: /PGOOD LEDs/ Drew Maatman C1604

Id: 24/25 Title: Analog Clock

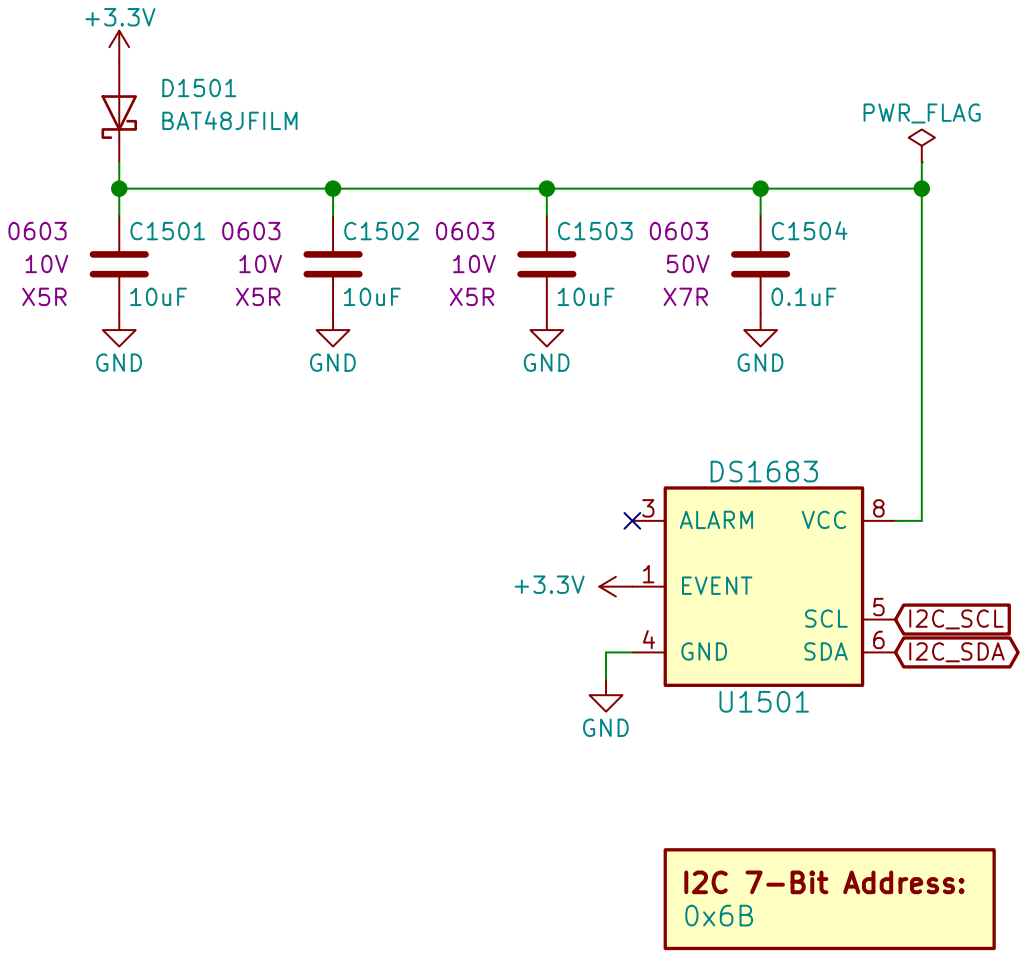
[picture p28: page 25]

Sheet: /Time of Flight/ Drew Maatman

File: Time_of_Flight.sch
Id: 25/25 Title: Analog Clock
