drewsum/Analog_Clock/hdw/design_files/POS20.asc

C1: polcap; 10µ
C2: cap; 6800p
C3: polcap; 4.7µ
C4: cap; .01µ
D1: schottky; MBR0540
L1: ind; 10µ; Rser=0.11
Q1: NMOS; FDS6680A
R1: RES; 11.5k
R2: res; 1k
R3: res; 11.5k
R4: res; 22K
R5: res; 43.2K
R6: res; 200K
R7: res; 0.14
Rload: res; 200
U1: LT3757
V1: VOLTAGE; 12
Named nets: 0, OUT, IN
.tran 10m startup
