drewsum/Analog_Clock/hdw/Analog_Clock/Analog_Clock.kicad_pcb

## KiCad design hdw/Analog_Clock/Analog_Clock.kicad_pcb (2020-10-15)

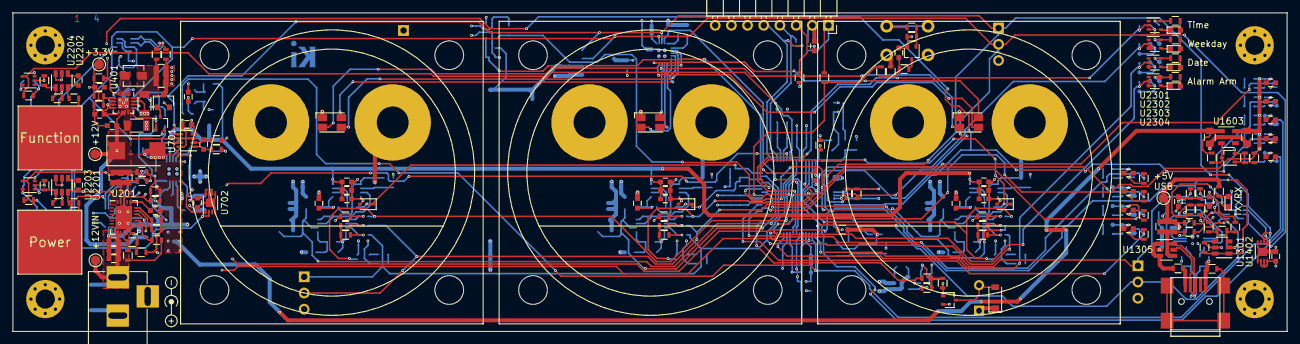
[picture p29: board Analog_Clock.kicad_pcb from above]

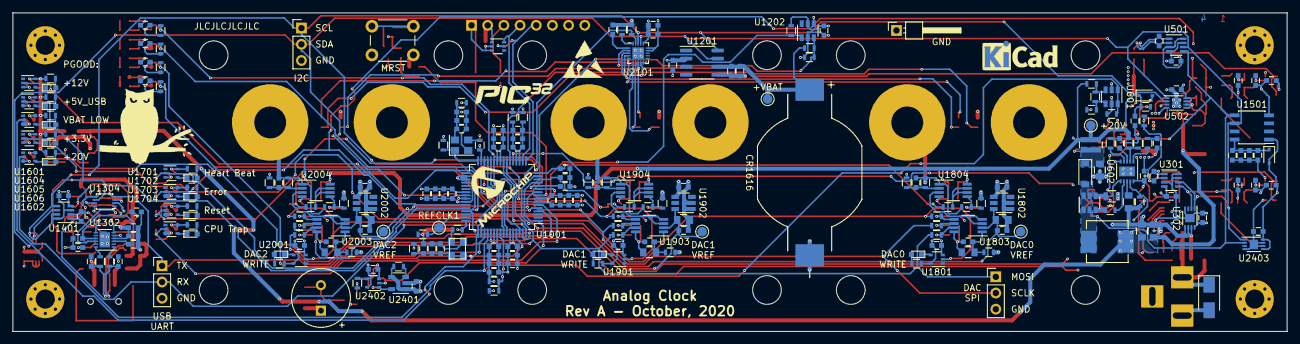
[picture p30: board Analog_Clock.kicad_pcb from below]

Board: 4 copper layers, 200.0 x 50.0 mm, 417 parts (203 on the bottom side), 202 nets.

Parts:
BT1202: CR1616_Holder; BAT_BU1632SM-JJ-GTR
BZ2401: CST-931RP-A; MagneticBuzzer_CUI_CST-931RP-A
C201, C203, C403, C904, C905, C910, C914, C918, C919, C1103, C1104, C1809, C1909, C2009, C2203, C2204: 10nF; C_0603
C202, C301, C302, C303, C404, C406, C501, C502, C503, C603, C604, C606, C701, C702, C703, C801, C802, C901, C902, C908, C912, C916, C917, C1101, C1102, C1202, C1203, C1204, C1205, C1301, C1302, C1304, C1306, C1307, C1310, C1312, C1401, C1402, C1403, C1504, C1602, C1603, C1605, C1606, C1607, C1701, C1702, C1703, C1704, C1801, C1802, C1806, C1807, C1808, C1811, C1812, C1901, C1902, C1906, C1907, C1908, C1911, C1912, C2001, C2002, C2006, C2007, C2008, C2011, C2012, C2103, C2201, C2202, C2207, C2208, C2301, C2302, C2303, C2304, C2401, C2402, C2403: 0.1uF; C_0603
C204, C906, C907, C911, C915, C920, C921, C1105, C1106, C1810, C1910, C2010: 1nF; C_0603
C205: 100uF; CP_Tantalum_Case-X_EIA-7343-43_Reflow
C401: 10uF; C_1206
C402, C903, C909, C913, C1201, C1303, C1501, C1502, C1503, C2101, C2102, C2205, C2206: 10uF; C_0603
C405: 100uF; C_1206
C601, C602, C607, C610: 10uF; C_0805
C605: 6.8nF; C_0603
C1309, C1311, C1805, C1905, C2005: 47pF; C_0603
C1601, C1604, C1803, C1804, C1903, C1904, C2003, C2004: 4.7uF; C_0805
D201: 24V; D_SMA
D401, D1501: BAT48JFILM; D_SOD-323
D601, D2401: MBR0580; D_SOD-123
D801: PESD3V3L5UY; SOT-363_SC-70-6
D1301, D2304: Yellow; LED_0603
D1601, D1602, D1603, D1605, D1701, D1801, D1901, D2001, D2301, D2302, D2303: Green; LED_0603
D1604, D1702, D1703, D1704: Red; LED_0603
D1802, D1902, D2002: ASMB-MTB0-0A3A2; LED_Avago_PLCC4_3.2x2.8mm_CW
D1803, D1903, D2003: BZX384-B3V3,115; D_SOD-323
H2501, H2502, H2503, H2504: 3mm Mounting Hole; MountingHole_3mm_Pad_Via
J201: +12V IN; BARREL_JACK
J801: PICKIT4; PICKIT4_Header
J1301: USB_B_Mini; USB_Mini-B
J2401: I2C; Pin_Header_Straight_1x03_Pitch2.54mm
J2402: USB UART; Pin_Header_Straight_1x03_Pitch2.54mm
J2403: DAC SPI; Pin_Header_Straight_1x03_Pitch2.54mm
L401: 3.3uH; L_Vishay_IHLP-1212
L601: 10uH; L_Vishay_IHLP-2525
L801, L802, L901, L902, L1101, L1102, L1301, L1302, L1801, L1901, L2001: 600R 0.5A; L_0603
MES1801, MES1901, MES2001: Voltmeter_DC; SO-45_Panel_Meter
Q401, Q801, Q1601, Q2401: BSS214NW; SOT-323_SC-70
Q402: ZXMS6004FFTA; SOT-23
Q601: FDC5612; SOT-23-6
R201: 51.1k; R_0603
R202: 1.15k; R_0603
R203, R209: 5.11k; R_0603
R204, R207, R211, R402, R403, R605, R607, R802, R804, R1001, R1002, R1102, R1103, R1106, R1107, R1203, R1305, R1602, R1603, R1701, R1702, R1705, R1706, R1804, R1805, R1807, R1904, R1905, R1907, R2004, R2005, R2007, R2101, R2203, R2204, R2205, R2206, R2207, R2208, R2301, R2302, R2305, R2306, R2402, R2403, R2405, R2407: 10k; R_0603
R205, R210, R401, R404, R406, R608, R610, R612, R801, R803, R1309, R1313, R1601, R1801, R1802, R1803, R1901, R1902, R1903, R2001, R2002, R2003, R2404, R2406: 10; R_0603
R206, R405, R1310: 0.02; R_0612
R208: 13k; R_0603
R407: 562k; R_0603
R408: 180k; R_0603
R601, R1306, R1308, R1314, R1315: 100k; R_0603
R602: 383; R_0603
R603: 1.87k; R_0603
R604, R613: 11.5k; R_0603
R606: 22k; R_0603
R609: 130m; R_0805
R611: 1; R_0612
R614, R805, R1301, R1604, R1605, R1606, R1607, R1608, R1703, R1704, R1707, R1708, R1806, R1812, R1906, R1912, R2006, R2012, R2303, R2304, R2307, R2308: 1k; R_0603
R1104, R1105: 100; R_0603
R1201, R2401: 1.07M; R_0603
R1202: 220k; R_0603
R1302: 487k; R_0603
R1303: 6.04k; R_0603
R1304: 40.2k; R_0603
R1311, R1312: 27; R_0603
R1808, R1809, R1908, R1909, R2008, R2009: 1.01k; R_0603
R1810, R1811, R1910, R1911, R2010, R2011: 9.09k; R_0603
R2102: 3.65k; R_0603
R2201, R2202: 499; R_0603
SW801: MRST; SW_PUSH_6mm
SW2201, SW2202: Cap_Touch; Capacitive_Touch_Pad
TP201: TP; Pin_Header_Angled_1x01_Pitch2.54mm
TP202, TP203, TP1801, TP1901, TP2001: TP_Pad; Test_Point
TP401, TP601, TP1102, TP1201, TP1301: TP; Test_Point
U201: TPS26600RHFT; QFN-24-1EP_4x5mm_Pitch0.5mm
U301, U501, U701, U1401: INA219BxDCN; SOT-23-8
U302, U502, U702, U1402, U2403: MCP9804; DFN-8-1EP_3x2mm_P0.5mm_EP1.3x1.5mm
U401: TPS62150; QFN-16-1EP_3x3mm_P0.5mm_EP1.8x1.8mm
U601, U1202, U1301: TLV6700; SOT-23-6
U602: LT3757; DFN-10-1EP_3x3mm_Pitch0.5mm
U1001: PIC32MZ0512EFE064T-I_PT; TQFP-64_10x10mm_P0.5mm
U1201: DS3231MZ; SOIC-8_3.9x4.9mm_P1.27mm
U1302: FT234XD; DFN-12-1EP_3x3mm_Pitch0.45mm
U1304: TXB0102DCU; VSSOP-8_2.4x2.1mm_P0.5mm
U1305: TPD3S014DBVR; SOT-23-6
U1501: DS1683; SOIC-8_3.9x4.9mm_Pitch1.27mm
U1601, U1602, U1604, U1606, U1701, U1702, U1703, U1704, U2301, U2302, U2303, U2304: 74LVC1G06; SOT-353_SC-70-5
U1603: LP2985-3.3; SOT-23-5
U1605, U1801, U1901, U2001: 74LVC1G07; SOT-353_SC-70-5
U1802, U1902, U2002: LT1790-2.048; TSOT-23-6
U1803, U1903, U2003: DAC8551; VSSOP-8_3.0x3.0mm_P0.65mm
U1804, U1904, U2004: OPA2197xDGK; VSSOP-8_3.0x3.0mm_P0.65mm
U2101: LP5009; UQFN-20-1EP_3x3mm_Pitch0.4mm
U2201, U2202: AT42QT1010-TSHR; SOT-23-6
U2203, U2204: 74LVC1G17; SOT-353_SC-70-5
U2401: LTC6900; SOT-23-5
U2402: 74LVC1G08; SOT-353_SC-70-5
X1101: ASE-8.000MHz; Oscillator_SMD_Abracon_ASE-4Pin_3.2x2.5mm
X1102: ECS-327KE

Connections:
+3.3VA_MZ: C917.1, C919.1, C921.1, L901.1, U1001.19
+3.3V_PGL: C1602.1, C1604.1, R1604.1, R1605.1, R1606.1, R1607.1, R1608.1, U1601.5, U1603.5
+3.3V_USB: C1301.1, C1307.1, C1312.1, R1314.1, R1315.1, U1302.3, U1302.9, U1304.7
+3V3: BZ2401.1, C302.1, C303.1, C406.1, C502.1, C503.1, C606.1, C702.1, C703.1, C802.1, C901.1, C902.1, C903.1, C904.1, C905.1, C906.1, C907.1, C908.1, C909.1, C910.1, C911.1, C912.1, C913.1, C914.1, C915.1, C916.1, C918.1, C920.1, C1203.1, C1204.1, C1304.1, C1310.1, C1402.1, C1403.1, C1603.1, C1605.1, C1606.1, C1607.1, C1701.1, C1702.1, C1703.1, C1704.1, C1801.1, C1802.1, C1901.1, C1902.1, C2001.1, C2002.1, C2102.1, C2103.1, C2201.1, C2202.1, C2207.1, C2208.1, C2301.1, C2302.1, C2303.1, C2304.1, C2401.1, C2402.1, C2403.1, D401.2, D801.1, D1501.2, D1802.1, D1902.1, D2002.1, D2401.1, J801.2, L901.2, L1101.2, L1102.2, L1801.2, L1901.2, L2001.2, Q402.3, R402.1, R405.2, R406.2, R407.1, R607.2, R804.1, R1001.1, R1002.1, R1203.1, R1305.1, R1306.1, R1308.1, R1703.1, R1704.1, R1705.1, R1707.1, R1708.1, R1804.1, R1806.1, R1904.1, R1906.1, R2004.1, R2006.1, R2303.1, R2304.1, R2307.1, R2308.1, R2401.1, R2403.1, SW801.1, TP401.1, U301.4, U302.8, U401.14, U501.4, U501.7, U502.7, U502.8, U601.5, U701.4, U702.6, U702.8, U1001.8, U1001.26, U1001.39, U1001.54, U1001.60, U1201.2, U1202.5, U1301.5, U1304.3, U1401.4, U1402.6, U1402.7, U1402.8, U1501.1, U1602.5, U1604.5, U1605.5, U1606.5, U1701.5, U1702.5, U1703.5, U1704.5, U1801.5, U1802.4, U1901.5, U1902.4, U2001.5, U2002.4, U2101.16, U2201.5, U2201.6, U2202.5, U2202.6, U2203.5, U2204.5, U2301.5, U2302.5, U2303.5, U2304.5, U2401.1, U2401.4, U2402.5, U2403.5, U2403.8
+5V_USB: C1302.1, C1303.1, C1306.1, R1301.1, R1302.1, R1309.2, R1310.1, TP1301.1, U1302.4
+12V: C205.1, C401.1, C404.1, C601.1, C602.1, C604.1, C1601.1, L601.1, R206.2, R208.1, R210.2, R1603.1, TP203.1, U401.10, U401.11, U401.12, U602.10, U1603.1
+12Vin: C202.1, C203.1, C204.1, D201.1, J201.1, R201.1, R204.1, TP202.1, U201.8, U201.9
+20V: C1808.1, C1809.1, C1810.1, C1908.1, C1909.1, C1910.1, C2008.1, C2009.1, C2010.1, R601.1, R611.2, R612.1, R613.1, TP601.1, U1804.8, U1904.8, U2004.8
/USB UART Bridge/BRIDGE_USB+: R1311.2, U1302.12
/USB UART Bridge/BRIDGE_USB-: R1312.2, U1302.1
/USB UART Bridge/CONN_USB+: C1309.1, J1301.3, R1311.1, U1305.6
/USB UART Bridge/CONN_USB-: C1311.1, J1301.2, R1312.1, U1305.5
Alarm_Arm_LED: R2306.1, U1001.63, U2304.2
Buzzer_Enable: R2405.2, U1001.1, U2402.2
CPU_Trap_LED: R1706.1, U1001.6, U1704.2
Cap_Touch_Function: R2208.1, U1001.22, U2204.4
Cap_Touch_Power: R2207.1, U1001.21, U2203.4
DAC0_VREF: C1803.1, C1805.1, TP1801.1, U1001.15, U1802.6, U1803.2
DAC1_VREF: C1903.1, C1905.1, TP1901.1, U1001.13, U1902.6, U1903.2
DAC2_VREF: C2003.1, C2005.1, TP2001.1, U1001.11, U2002.6, U2003.2
DAC_SPI_MOSI: J2403.1, R1802.1, R1902.1, R2002.1, U1001.23
DAC_SPI_SCLK: J2403.2, R1803.1, R1903.1, R2003.1, U1001.29
Error_LED: R1702.1, U1001.10, U1702.2
Function_Date_LED: R2305.1, U1001.61, U2303.2
Function_Time_LED: R2301.1, U1001.58, U2301.2
Function_Weekday_LED: R2302.1, U1001.62, U2302.2
GND: BT1202.2, C202.2, C203.2, C204.2, C205.2, C302.2, C303.2, C401.2, C402.2, C403.2, C404.2, C405.2, C406.2, C502.2, C503.2, C601.2, C602.2, C603.2, C604.2, C605.2, C606.2, C607.2, C610.2, C702.2, C703.2, C801.2, C802.2, C901.2, C902.2, C903.2, C904.2, C905.2, C906.2, C907.2, C908.2, C909.2, C910.2, C911.2, C912.2, C913.2, C914.2, C915.2, C916.2, C918.2, C920.2, C1101.2, C1102.2, C1103.2, C1104.2, C1105.2, C1106.2, C1201.2, C1202.2, C1203.2, C1204.2, C1205.2, C1301.2, C1302.2, C1303.2, C1304.2, C1306.2, C1307.2, C1309.2, C1310.2, C1311.2, C1312.2, C1402.2, C1403.2, C1501.2, C1502.2, C1503.2, C1504.2, C1601.2, C1602.2, C1603.2, C1604.2, C1605.2, C1606.2, C1607.2, C1701.2, C1702.2, C1703.2, C1704.2, C1801.2, C1802.2, C1803.2, C1804.2, C1805.2, C1806.2, C1807.2, C1808.2, C1809.2, C1810.2, C1812.2, C1901.2, C1902.2, C1903.2, C1904.2, C1905.2, C1906.2, C1907.2, C1908.2, C1909.2, C1910.2, C1912.2, C2001.2, C2002.2, C2003.2, C2004.2, C2005.2, C2006.2, C2007.2, C2008.2, C2009.2, C2010.2, C2012.2, C2101.2, C2102.2, C2103.2, C2201.2, C2202.2, C2205.2, C2206.2, C2207.2, C2208.2, C2301.2, C2302.2, C2303.2, C2304.2, C2401.2, C2402.2, C2403.2, D201.2, D801.2, D1803.2, D1903.2, D2003.2, J201.2, J201.3, J1301.5, J2401.3, J2402.3, J2403.3, L802.2, L902.2, L1302.1, MES1801.1, MES1901.1, MES2001.1, Q401.2, Q402.2, Q801.2, Q1601.2, Q2401.2, R209.2, R408.2, R603.2, R604.2, R605.2, R609.2, R614.2, R802.2, R1102.2, R1103.2, R1106.2, R1107.2, R1202.2, R1304.2, R1602.2, R1701.2, R1702.2, R1706.2, R1805.2, R1807.2, R1808.2, R1809.2, R1905.2, R1907.2, R1908.2, R1909.2, R2005.2, R2007.2, R2008.2, R2009.2, R2101.2, R2102.2, R2203.2, R2204.2, R2207.2, R2208.2, R2301.2, R2302.2, R2305.2, R2306.2, R2402.1, R2404.2, R2405.1, R2407.1, TP201.1, U201.17, U301.3, U301.7, U301.8, U302.4, U302.5, U302.6, U302.7, U302.9, U401.6, U401.7, U401.8, U401.15, U401.16, U401.17, U501.3, U501.8, U502.4, U502.5, U502.6, U502.9, U601.2, U602.5, U602.11, U701.3, U701.8, U702.4, U702.5, U702.7, U702.9, U1001.7, U1001.25, U1001.34, U1001.35, U1001.40, U1001.55, U1001.59, U1201.5, U1202.2, U1202.4, U1301.2, U1302.5, U1302.13, U1304.2, U1305.2, U1401.3, U1401.8, U1402.4, U1402.5, U1402.9, U1501.4, U1601.3, U1602.3, U1603.2, U1604.3, U1605.3, U1606.3, U1701.3, U1702.3, U1703.3, U1704.3, U1801.3, U1802.1, U1802.2, U1803.8, U1804.4, U1901.3, U1902.1, U1902.2, U1903.8, U1904.4, U2001.3, U2002.1, U2002.2, U2003.8, U2004.4, U2101.14, U2101.15, U2101.21, U2201.2, U2202.2, U2203.3, U2204.3, U2301.3, U2302.3, U2303.3, U2304.3, U2401.2, U2402.3, U2403.4, U2403.6, U2403.7, U2403.9, X1101.2, X1102.2
GNDA_MZ: C917.2, C919.2, C921.2, L902.1, U1001.20
Heartbeat_LED: R1701.1, U1001.4, U1701.2
I2C_SCL: J2401.1, R1002.2, U301.5, U302.2, U501.5, U502.2, U701.5, U702.2, U1001.42, U1201.8, U1401.5, U1401.7, U1402.2, U1501.5, U2101.18, U2403.2
I2C_SDA: J2401.2, R1001.2, U301.6, U302.1, U501.6, U502.1, U701.6, U701.7, U702.1, U1001.41, U1201.7, U1401.6, U1402.1, U1501.6, U2101.17, U2403.1
METER0_LED_B: D1802.2, U2101.4
METER0_LED_G: D1802.3, U2101.3
METER0_LED_R: D1802.4, U2101.2
METER1_LED_B: D1902.2, U2101.7
METER1_LED_G: D1902.3, U2101.6
METER1_LED_R: D1902.4, U2101.5
METER2_LED_B: D2002.2, U2101.10
METER2_LED_G: D2002.3, U2101.9
METER2_LED_R: D2002.4, U2101.8
Meter_LED_Enable: R2101.1, U1001.57, U2101.19
unnamed: BZ2401.2, D2401.2, Q2401.3
unnamed: C201.1, U201.20
unnamed: C201.2, R203.2, R207.2, R211.2, U201.15, U201.25
unnamed: C402.1, D401.1, R403.1
unnamed: C403.1, U401.9
unnamed: C405.1, L401.2, R404.2, R405.1
unnamed: C603.1, U602.3
unnamed: C605.1, R606.2
unnamed: C607.1, U602.8
unnamed: C610.1, D601.1, R610.1, R611.1
unnamed: C801.1, R803.2, R804.2, R805.2
unnamed: C1101.1, C1103.1, C1105.1, L1101.1, X1101.4
unnamed: C1102.1, C1104.1, C1106.1, L1102.1, X1102.1, X1102.4
unnamed: C1501.1, C1502.1, C1503.1, C1504.1, D1501.1, U1501.8
unnamed: C1804.1, C1806.1, L1801.1, U1803.1
unnamed: C1807.1, R1808.1, R1810.2, U1804.5
unnamed: C1811.1, MES1801.2, R1810.1, R1811.1, U1804.1
unnamed: C1811.2, R1809.1, R1811.2, U1804.2
unnamed: C1904.1, C1906.1, L1901.1, U1903.1
unnamed: C1907.1, R1908.1, R1910.2, U1904.5
unnamed: C1911.1, MES1901.2, R1910.1, R1911.1, U1904.1
unnamed: C1911.2, R1909.1, R1911.2, U1904.2
unnamed: C2004.1, C2006.1, L2001.1, U2003.1
unnamed: C2007.1, R2008.1, R2010.2, U2004.5
unnamed: C2011.1, MES2001.2, R2010.1, R2011.1, U2004.1
unnamed: C2011.2, R2009.1, R2011.2, U2004.2
unnamed: C2101.1, U2101.1
unnamed: C2203.1, U2201.4
unnamed: C2203.2, R2201.2, U2201.3
unnamed: C2204.1, U2202.4
unnamed: C2204.2, R2202.2, U2202.3
unnamed: C2205.1, R2205.1, U2203.2
unnamed: C2206.1, R2206.1, U2204.2
unnamed: D601.2, L601.2, Q601.1, Q601.2, Q601.5, Q601.6
unnamed: D801.3, J801.1, L801.2
unnamed: D1301.2, R1301.2
unnamed: D1601.1, U1601.4
unnamed: D1601.2, R1604.2
unnamed: D1602.1, U1602.4
unnamed: D1602.2, R1605.2
unnamed: D1603.1, U1604.4
unnamed: D1603.2, R1606.2
unnamed: D1604.1, U1605.4
unnamed: D1604.2, R1607.2
unnamed: D1605.1, U1606.4
unnamed: D1605.2, R1608.2
unnamed: D1701.1, U1701.4
unnamed: D1701.2, R1703.2
unnamed: D1702.1, U1702.4
unnamed: D1702.2, R1704.2
unnamed: D1703.1, U1703.4
unnamed: D1703.2, R1707.2
unnamed: D1704.1, U1704.4
unnamed: D1704.2, R1708.2
unnamed: D1801.1, U1801.4
unnamed: D1801.2, R1806.2
unnamed: D1901.1, U1901.4
unnamed: D1901.2, R1906.2
unnamed: D2001.1, U2001.4
unnamed: D2001.2, R2006.2
unnamed: D2301.1, U2301.4
unnamed: D2301.2, R2303.2
unnamed: D2302.1, U2302.4
unnamed: D2302.2, R2304.2
unnamed: D2303.1, U2303.4
unnamed: D2303.2, R2307.2
unnamed: D2304.1, U2304.4
unnamed: D2304.2, R2308.2
unnamed: J801.3, L802.1
unnamed: J1301.1, L1301.1
unnamed: J1301.6, L1302.2
unnamed: L401.1, U401.1, U401.2, U401.3
unnamed: L1301.2, U1305.1, U1305.3
unnamed: Q401.3, Q402.1, R403.2
unnamed: Q601.3, R608.1
unnamed: Q601.4, R609.1, U602.6
unnamed: Q801.1, R801.2, R802.1
unnamed: Q801.3, R803.1
unnamed: Q1601.1, R1601.2, R1602.1
unnamed: Q1601.3, R1603.2, U1603.3
unnamed: Q2401.1, R2406.1, R2407.2
unnamed: R201.2, R202.1, U201.10
unnamed: R202.2, R203.1, U201.12
unnamed: R204.2, U201.14
unnamed: R205.2, R206.1, U201.23, U201.24
unnamed: R207.1, U201.19
unnamed: R211.1, U201.18
unnamed: R407.2, R408.1, U401.5
unnamed: R601.2, R602.1, U601.3
unnamed: R602.2, R603.1, U601.4
unnamed: R604.1, U602.4
unnamed: R606.1, U602.1
unnamed: R608.2, U602.7
unnamed: R613.2, R614.1, U602.2
unnamed: R801.1, SW801.2
unnamed: R1104.1, X1101.3
unnamed: R1105.1, X1102.3
unnamed: R1302.2, R1303.1, U1301.3
unnamed: R1303.2, R1304.1, U1301.4
unnamed: R1310.2, R1313.2, U1305.4
unnamed: R1801.2, R1804.2, U1803.5
unnamed: R1802.2, R1805.1, U1803.7
unnamed: R1803.2, R1807.1, U1803.6
unnamed: R1812.2, U1804.6, U1804.7
unnamed: R1901.2, R1904.2, U1903.5
unnamed: R1902.2, R1905.1, U1903.7
unnamed: R1903.2, R1907.1, U1903.6
unnamed: R1912.2, U1904.6, U1904.7
unnamed: R2001.2, R2004.2, U2003.5
unnamed: R2002.2, R2005.1, U2003.7
unnamed: R2003.2, R2007.1, U2003.6
unnamed: R2012.2, U2004.6, U2004.7
unnamed: R2102.1, U2101.20
unnamed: R2201.1, SW2201.1
unnamed: R2202.1, SW2202.1
unnamed: R2203.1, R2205.2, U2201.1
unnamed: R2204.1, R2206.2, U2202.1
unnamed: R2401.2, U2401.3
unnamed: R2402.2, U2401.5, U2402.1
unnamed: R2406.2, U2402.4
unnamed: U1803.3, U1803.4, U1804.3
unnamed: U1903.3, U1903.4, U1904.3
unnamed: U2003.3, U2003.4, U2004.3
PIC32MZ_ICSPCLK: D801.5, J801.5, U1001.17
PIC32MZ_ICSPDAT: D801.6, J801.4, U1001.18
PIC32MZ_POSC_EC: R1104.2, R1106.1, U1001.31
PIC32MZ_POSC_EC_Enable: R1103.1, U1001.32, X1101.1
PIC32MZ_REFCLK1: R1102.1, TP1102.1, U1001.47
PIC32MZ_SOSC: R1105.2, R1107.1, U1001.48
POS3P3_PGL_SHDN: R1601.1, U1001.64
POS3P3_PGOOD: R402.2, U401.4, U1001.43, U1606.2
POS3P3_RUN: Q401.1, R401.1, U401.13
POS3P3_SNS+: C501.1, R404.1, U501.1
POS3P3_SNS-: C501.2, R406.1, U501.2
POS5_USB_PGOOD: R1305.2, U1001.44, U1301.1, U1301.6, U1304.6, U1604.2
POS5_USB_SNS+: C1401.1, R1313.1, U1401.1
POS5_USB_SNS-: C1401.2, R1309.1, U1401.2
POS12_PGOOD: R208.2, R209.1, R401.2, U201.22, U1001.45, U1601.2
POS12_SNS+: C301.1, R205.1, U301.1
POS12_SNS-: C301.2, R210.1, U301.2
POS20_PGOOD: R607.1, U601.1, U601.6, U1001.52, U1602.2
POS20_RUN: R605.1, U602.9, U1001.53
POS20_SNS+: C701.1, R610.2, U701.1
POS20_SNS-: C701.2, R612.2, U701.2
Reset_LED: R1705.2, U1001.5, U1703.2
Telemetry_Hardstrap: R2403.2, R2404.1, U1001.56
USB_UART_RX: J2402.2, R1308.2, U1001.50, U1304.5
USB_UART_RX_BUF: R1314.2, U1302.7, U1304.8
USB_UART_TX: J2402.1, R1306.2, U1001.51, U1304.4
USB_UART_TX_BUF: R1315.2, U1302.10, U1304.1
VBAT: BT1202.1, C1201.1, C1202.1, R1201.1, TP1201.1, U1201.6
VBAT_ADC: C1205.1, R1201.2, R1202.1, U1001.30, U1202.3
VBAT_PGOOD: R1203.2, U1001.49, U1202.1, U1605.2
VDAC_0_ADC: C1812.1, D1803.1, R1812.1, U1001.16
VDAC_1_ADC: C1912.1, D1903.1, R1912.1, U1001.14
VDAC_2_ADC: C2012.1, D2003.1, R2012.1, U1001.12
~DAC_SPI_SYNC_0: R1801.1, U1001.24, U1801.2
~DAC_SPI_SYNC_1: R1901.1, U1001.27, U1901.2
~DAC_SPI_SYNC_2: R2001.1, U1001.28, U2001.2
~PIC32MZ_MCLR: L801.1, R805.1, U1001.9
~USB_ACTIVE: D1301.1, U1302.6
