drewsum/Analog_Clock/sfw/U1001_Firmware/Analog_Clock.X/telemetry.h

/* ************************************************************************** */
/** Descriptive File Name

  @Company
    Company Name

  @File Name
    filename.h

  @Summary
    Brief description of the file.

  @Description
    Describe the purpose of this file.
 */
/* ************************************************************************** */

#ifndef _TELEMETRY_H    /* Guard against multiple inclusion */
#define _TELEMETRY_H

#include <xc.h>

// This is a typedef for holding the different types of telemetry data for each power supply
typedef struct telemetry_paramaters_ps_u {
    
    double temperature;
    double voltage;
    double current;
    double power;
    
} telemetry_parameters_ps_t;


// This is the structure that holds all telemetry data in the entire system
volatile __attribute__((coherent)) struct telemetry_s {
    
    telemetry_parameters_ps_t pos12;
    telemetry_parameters_ps_t pos3p3;
    telemetry_parameters_ps_t pos20;
    telemetry_parameters_ps_t usb;
    double ambient_temperature;
    double backup_rtc_temperature;
    double mcu_die_temp;
    double adc_vref_voltage;
    double backup_battery_voltage;
    double dac0_output_voltage;
    double dac0_ref_voltage;
    double dac1_output_voltage;
    double dac1_ref_voltage;
    double dac2_output_voltage;
    double dac2_ref_voltage;
    
} telemetry;

// These flags are used to keep enable and request live telemetry updates
volatile __attribute__((coherent)) __attribute__((persistent)) uint8_t live_telemetry_enable;
volatile __attribute__((coherent)) uint8_t live_telemetry_print_request;

// This prints all telemetry data in an easily digested format
void printCurrentTelemetry(void);


#endif /* _TELEMETRY_H */

/* *****************************************************************************
 End of File
 */
