drewsum/Analog_Clock/(commit log)

2020-04-13 Started KiCad project
    [Analog_Clock.kicad_pcb, Analog_Clock.sch, Backup_RTC.sch, Meter0_DAC.sch, Meter1_DAC.sch, Meter2_DAC.sch, PGOOD_LEDs.sch, PIC32MZ.sch]
2020-04-17 More schematic work
    [Analog_Clock.sch, Backup_RTC.sch, Meter0_DAC.sch, Meter1_DAC.sch, Meter2_DAC.sch, PGOOD_LEDs.sch, PIC32MZ.sch, PIC32MZ_Bypass.sch]
2020-08-01 a few sch adjustments
    [PIC32MZ.sch, PIC32MZ_Bypass.sch, PIC32MZ_Clocking.sch, PIC32MZ_Programming.sch, POS12_Input.sch, POS12_Telemetry.sch, POS3P3_Power_Supply.sch, POS3P3_Telemetry.sch]
2020-08-03 More sch work
    [Analog_Clock.sch, Backup_RTC.sch, LED_Driver.sch, Meter0.sch, Meter0_DAC.sch, Meter1.sch, Meter2.sch, PGOOD_LEDs.sch]
2020-08-04 more sch progress
    [Analog_Clock.sch, Backup_RTC.sch, Function_LEDs.sch, LED_Driver.sch, Meter0.sch, Meter1.sch, Meter2.sch, PGOOD_LEDs.sch]
2020-08-06 Added +20V power supply, updated input power sheet
    [Backup_RTC.sch, POS12_Input.sch, POS20_Power_Supply.sch]
2020-08-08 some +20V boost supply work
    [POS20.xls, POS20_Power_Supply.sch]
2020-08-13 more analog work, added some more sch stuff
    [Analog_Clock.sch, Backup_RTC.sch, Function_LEDs.sch, LED_Driver.sch, Meter0.sch, Meter1.sch, Meter2.sch, Misc_Circuits.sch]
2020-08-15 big sch push
    [Analog_Clock.sch, Backup_RTC.sch, Function_LEDs.sch, LED_Driver.sch, Mechanical.sch, Meter0.sch, Meter1.sch, Meter2.sch]
2020-08-15 Much more schematic progress
    [Analog_Clock.sch, Backup_RTC.sch, Function_LEDs.sch, LED_Driver.sch, Mechanical.sch, Meter0.sch, Meter1.sch, Meter2.sch]
2020-08-15 made netlist, started PCB
    [Analog_Clock.kicad_pcb, Meter0.sch, Meter1.sch, Meter2.sch]
2020-08-16 Changed VBAT ADC circuit
    [Analog_Clock.kicad_pcb, Backup_RTC.sch]
2020-08-16 started arranging parts on PCB
    [Analog_Clock.kicad_pcb]
2020-08-20 more PCB grouping
    [Analog_Clock.kicad_pcb, Backup_RTC.sch, Meter0.sch, Meter1.sch, Meter2.sch, PIC32MZ_Programming.sch]
2020-08-25 Arranged more components on PCB
    [Analog_Clock.kicad_pcb, Backup_RTC.sch, PIC32MZ.sch, PIC32MZ_Clocking.sch, USB_Uart_Bridge.sch]
2020-09-20 More PCB arrangement
    [Analog_Clock.kicad_pcb, Analog_Clock.sch, Backup_RTC.sch, Function_LEDs.sch, LED_Driver.sch, Mechanical.sch, Meter0.sch, Meter1.sch]
2020-09-20 Major USB restructuring
    [Analog_Clock.kicad_pcb, Analog_Clock.sch, Backup_RTC.sch, Function_LEDs.sch, LED_Driver.sch, Mechanical.sch, Meter0.sch, Meter1.sch]
2020-09-20 Finished arranging parts, few netlist changes
    [Analog_Clock.kicad_pcb, POS20_Power_Supply.sch]
2020-09-20 Board outline
    [Analog_Clock.kicad_pcb]
2020-09-20 more PCB placement
    [Analog_Clock.kicad_pcb]
2020-09-20 moar PCB placement
    [Analog_Clock.kicad_pcb]
2020-09-20 finished first pass PCB placement
    [Analog_Clock.kicad_pcb]
2020-09-21 A lot more PCB work
    [Analog_Clock.kicad_pcb]
2020-09-26 started routing
    [Analog_Clock.kicad_pcb]
2020-09-26 more routing
    [Analog_Clock.kicad_pcb]
2020-09-27 moar routing
    [Analog_Clock.kicad_pcb]
2020-09-27 finished routing subcircuits
    [Analog_Clock.kicad_pcb]
2020-09-27 autorouting, cleanups
    [Analog_Clock.kicad_pcb]
2020-10-15 Added BOM
    [Analog_Clock.csv, Analog_Clock.kicad_pcb, Analog_Clock_BOM.xlsx]
2020-10-15 got PIC booting out of reset, setting up GPIO, clocking
    [configuration.h]
2020-10-19 Fixed some GPIO/OSC setup issues
    [device_control.c, gpio_setup.c, main.c]
2020-10-19 ported heartbeat timer
2020-10-20 added some clock stability changes at boot
    [device_control.c]
2020-10-20 got heartbeat PWM working, ported error handler and WDT
    [error_handler.c, main.c]
2020-10-20 ported heartbeat services, more stability attempts
    [device_control.c, heartbeat_services.c, heartbeat_services.h, main.c]
2020-10-20 ported USB UART, associated code
2020-10-20 few USB command fixes
    [main.c]
2020-10-21 ported cause of reset
    [main.c]
2020-10-21 ported I2C master code
2020-10-22 Ported temp sensors
2020-10-22 ported power monitors
2020-10-28 got basic ADC stuff working
2020-10-30 solved some ADC issues
    [adc_channels.c, heartbeat_services.c, telemetry.c, telemetry.h]
2020-10-30 got last ADC channel working
2020-10-30 started LP5009 led driver code
2020-10-30 added LP5009 print status function
2020-10-31 Added basic cap button code
2020-11-02 Added SPI DAC control code, SPI master port code
2020-11-02 Some bug fixes, some SPI DAC progress
    [main.c, power_monitors.c, spi_dac.c, spi_master.c]
2020-11-03 Got SPI DACs working
2020-11-04 added PGOOD disable on power button press
2020-11-05 started on meter inserts
2020-11-05 more meter insert work
2020-11-07 finished face plate files
2020-11-13 bug fixes, added DAC power down
    [main.c, spi_dac.c, spi_dac.h, user_interface.c]
2020-12-06 meter range recalibration, INA219 status bug fixes
    [heartbeat_services.h, ina219_power_monitor.c, user_interface.c]
2020-12-06 added inverted meter inserts
2022-01-07 Update pgood_monitor.c
    fixed bug with `POS3P3_PGL_SHDN_PIN` reference in power good monitor
    [pgood_monitor.c]
